aeronerd/KiCad/projects/DemoBoard1/pcb_resources/heart-shape.dxf

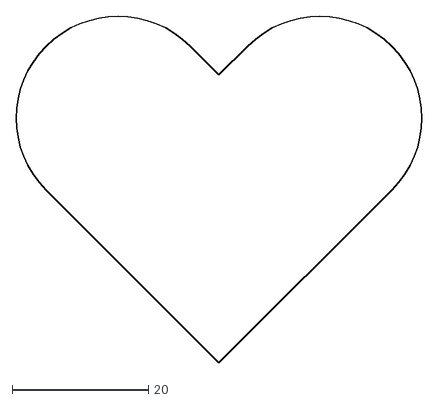
[picture p1: CAD file, 2018-10-02]
projects/DemoBoard1/pcb_resources/heart-shape.dxf
59.6 x 50.9
