aeronerd/KiCad/projects/BikeLightComputerRev2/BikeLightComputerRev2.kicad_pcb

## KiCad design projects/BikeLightComputerRev2/BikeLightComputerRev2.kicad_pcb (2020-08-28)

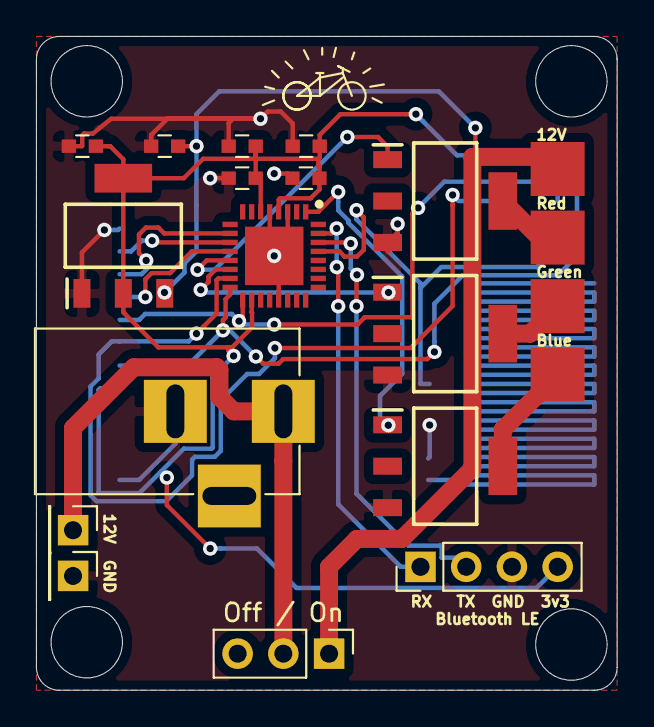
[picture p2: board BikeLightComputerRev2.kicad_pcb from above]

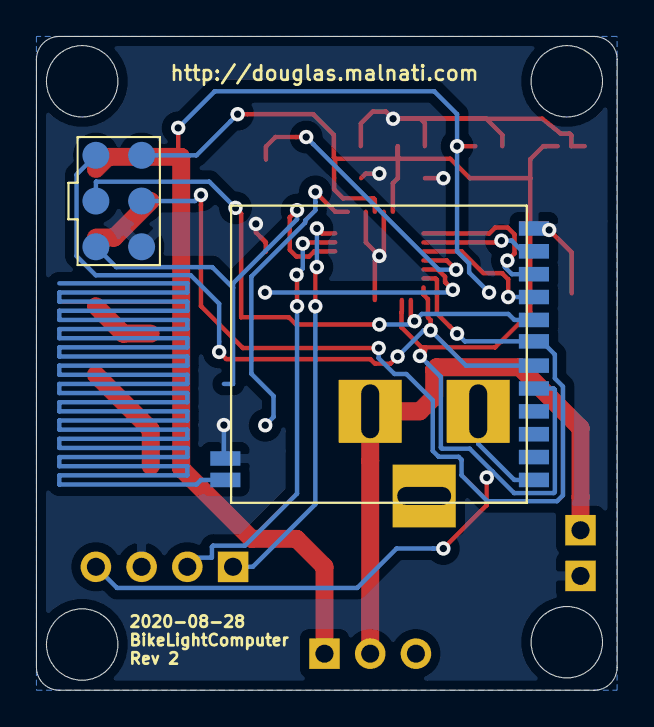
[picture p3: board BikeLightComputerRev2.kicad_pcb from below]

Board: 2 copper layers, 32.3 x 36.3 mm, 27 parts (7 on the bottom side), 19 nets.

Parts:
C1, C2, C3, C4, C5, C6: 1uF; C_0603
IC1, IC2, IC3: MOSFET_SOT223_FQT13N06TF; SOT-223-4
IC4: REG_3V3_NCP1117ST33T3G; SOT-223-4
J1: Barrel_Jack_MountingPin; BARREL_JACK
J3, J4: Conn_01x01_Male; Socket_Strip_Straight_1x01_Pitch2.54mm
J5: Conn_01x04_Female; Socket_Strip_Straight_1x04_Pitch2.54mm
J6, J7, J8, J9: Conn_01x01_Male; Measurement_Point_Square-SMD-Pad_Big
J10, J11, J12, J13, J14, J15: Conn_01x01_Male; Measurement_Point_Round-SMD-Pad_Small
J16: Conn_01x03_Male; Socket_Strip_Straight_1x03_Pitch2.54mm
U1: ATMEGA328P-MU
U2: RF4463PRO_LiteralLayout

Connections:
AVR_PWM_BLUE: IC3.1, U1.1
AVR_PWM_GREEN: IC2.1, U1.14
AVR_PWM_RED: IC1.1, U1.13
AVR_SER_RX: J5.2, U1.30
AVR_SER_TX: J5.1, U1.31
GND: C1.1, C2.1, C3.1, C4.1, C5.2, C6.1, IC1.3, IC2.3, IC3.3, IC4.1, J1.2, J4.1, J5.3, J15.1, U1.3, U1.5, U1.21, U1.33, U2.1, U2.12, U2.13
unnamed: IC1.4, J7.1
unnamed: IC2.4, J8.1
unnamed: IC3.4, J9.1
unnamed: J1.1, J3.1, J16.2
RADIO_NIRQ: U1.10, U2.10
RADIO_NSEL: U1.12, U2.9
RADIO_SDN: U1.11, U2.11
SPI_MISO: J10.1, U1.16, U2.6
SPI_MOSI: J14.1, U1.15, U2.7
SPI_RESET: J12.1, U1.29
SPI_SCK: J11.1, U1.17, U2.8
VCC: C1.2, C2.2, C3.2, C4.2, C6.2, IC4.2, IC4.4, J5.4, J13.1, U1.4, U1.6, U1.18, U2.5
VOLTAGE_INPUT: C5.1, IC4.3, J6.1, J16.1
