aeronerd/KiCad/projects/BreakoutSI4463PRORev3/BreakoutSI4463PRORev3.kicad_pcb

## KiCad design projects/BreakoutSI4463PRORev3/BreakoutSI4463PRORev3.kicad_pcb (2020-07-12)

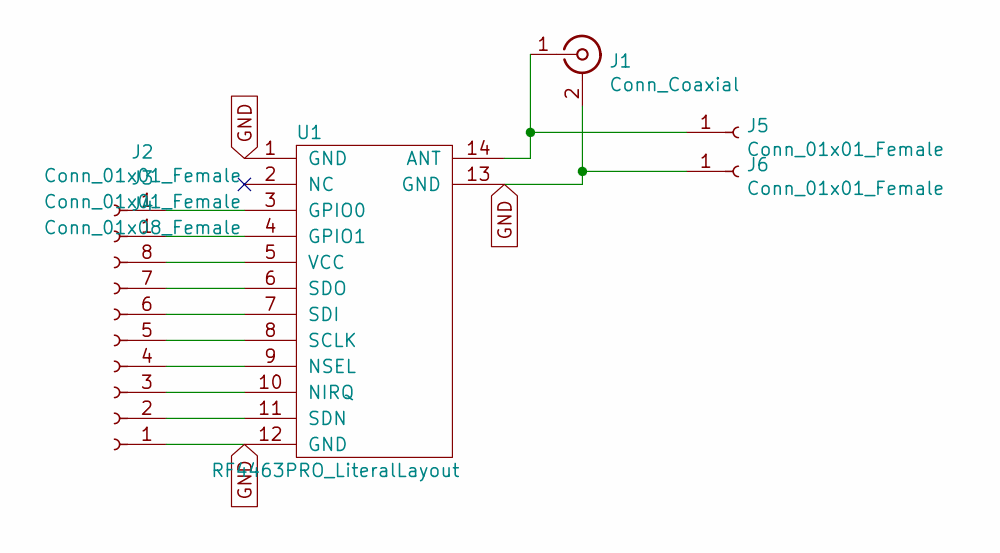
[picture p4: schematic BreakoutSI4463PRORev3.sch]

Parts:
J1: Conn_Coaxial; SMA_EdgeMount_BackOnly
J2, J3, J5, J6: Conn_01x01_Female; Pin_Header_Straight_1x01_Pitch2.54mm
J4: Conn_01x08_Female; Pin_Header_Straight_1x08_Pitch2.54mm
U1: RF4463PRO_LiteralLayout

Connections:
GND: J1.2 (Ext), J4.1, J6.1, U1.1 (GND), U1.12 (GND), U1.13 (GND)
unnamed: J1.1 (In), J5.1, U1.14 (ANT)
unnamed: J2.1, U1.3 (GPIO0)
unnamed: J3.1, U1.4 (GPIO1)
unnamed: J4.2, U1.11 (SDN)
unnamed: J4.3, U1.10 (NIRQ)
unnamed: J4.4, U1.9 (NSEL)
unnamed: J4.5, U1.8 (SCLK)
unnamed: J4.6, U1.7 (SDI)
unnamed: J4.7, U1.6 (SDO)
unnamed: J4.8, U1.5 (VCC)

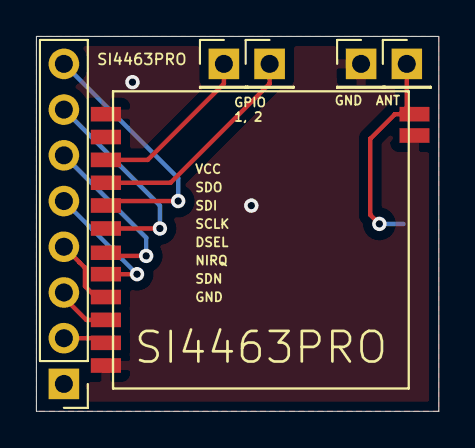
[picture p5: board BreakoutSI4463PRORev3.kicad_pcb from above]

Board: 2 copper layers, 22.4 x 20.8 mm, 7 parts (0 on the bottom side), 11 nets.
