aeronerd/KiCad/projects/BreakoutSI4463PRORev2/BreakoutSI4463PRORev2.kicad_pcb

## KiCad design projects/BreakoutSI4463PRORev2/BreakoutSI4463PRORev2.kicad_pcb (2020-06-27)

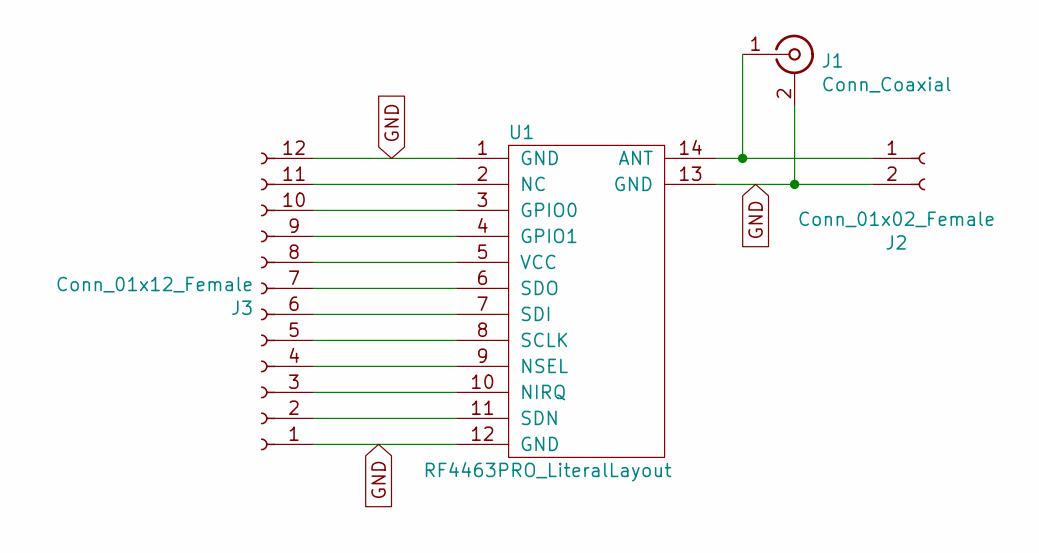
[picture p6: schematic BreakoutSI4463PRORev2.sch]

Parts:
J1: Conn_Coaxial; SMA_Samtec_SMA-J-P-X-ST-EM1_EdgeMount
J2: Conn_01x02_Female; Socket_Strip_Straight_1x02_Pitch2.54mm
J3: Conn_01x12_Female; Socket_Strip_Straight_1x12_Pitch2.54mm
U1: RF4463PRO_LiteralLayout

Connections:
GND: J1.2 (Ext), J2.2, J3.1, J3.12, U1.1 (GND), U1.12 (GND), U1.13 (GND)
unnamed: J1.1 (In), J2.1, U1.14 (ANT)
unnamed: J3.2, U1.11 (SDN)
unnamed: J3.3, U1.10 (NIRQ)
unnamed: J3.4, U1.9 (NSEL)
unnamed: J3.5, U1.8 (SCLK)
unnamed: J3.6, U1.7 (SDI)
unnamed: J3.7, U1.6 (SDO)
unnamed: J3.8, U1.5 (VCC)
unnamed: J3.9, U1.4 (GPIO1)
unnamed: J3.10, U1.3 (GPIO0)
unnamed: J3.11, U1.2 (NC)

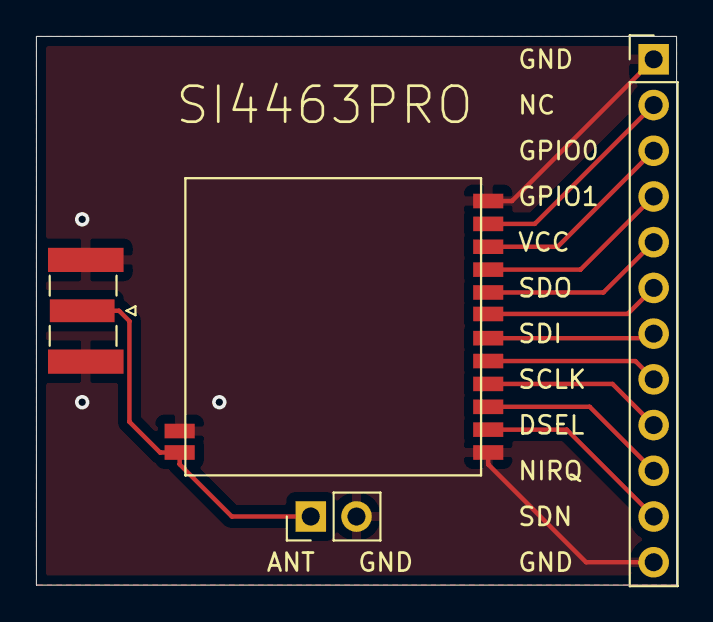
[picture p7: board BreakoutSI4463PRORev2.kicad_pcb from above]

Board: 2 copper layers, 35.6 x 30.5 mm, 4 parts (0 on the bottom side), 12 nets.
