aeronerd/KiCad/projects/PicoTrackerWSPR2Rev2/PicoTrackerWSPR2Rev2.kicad_pcb

## KiCad design projects/PicoTrackerWSPR2Rev2/PicoTrackerWSPR2Rev2.kicad_pcb (2020-04-08)

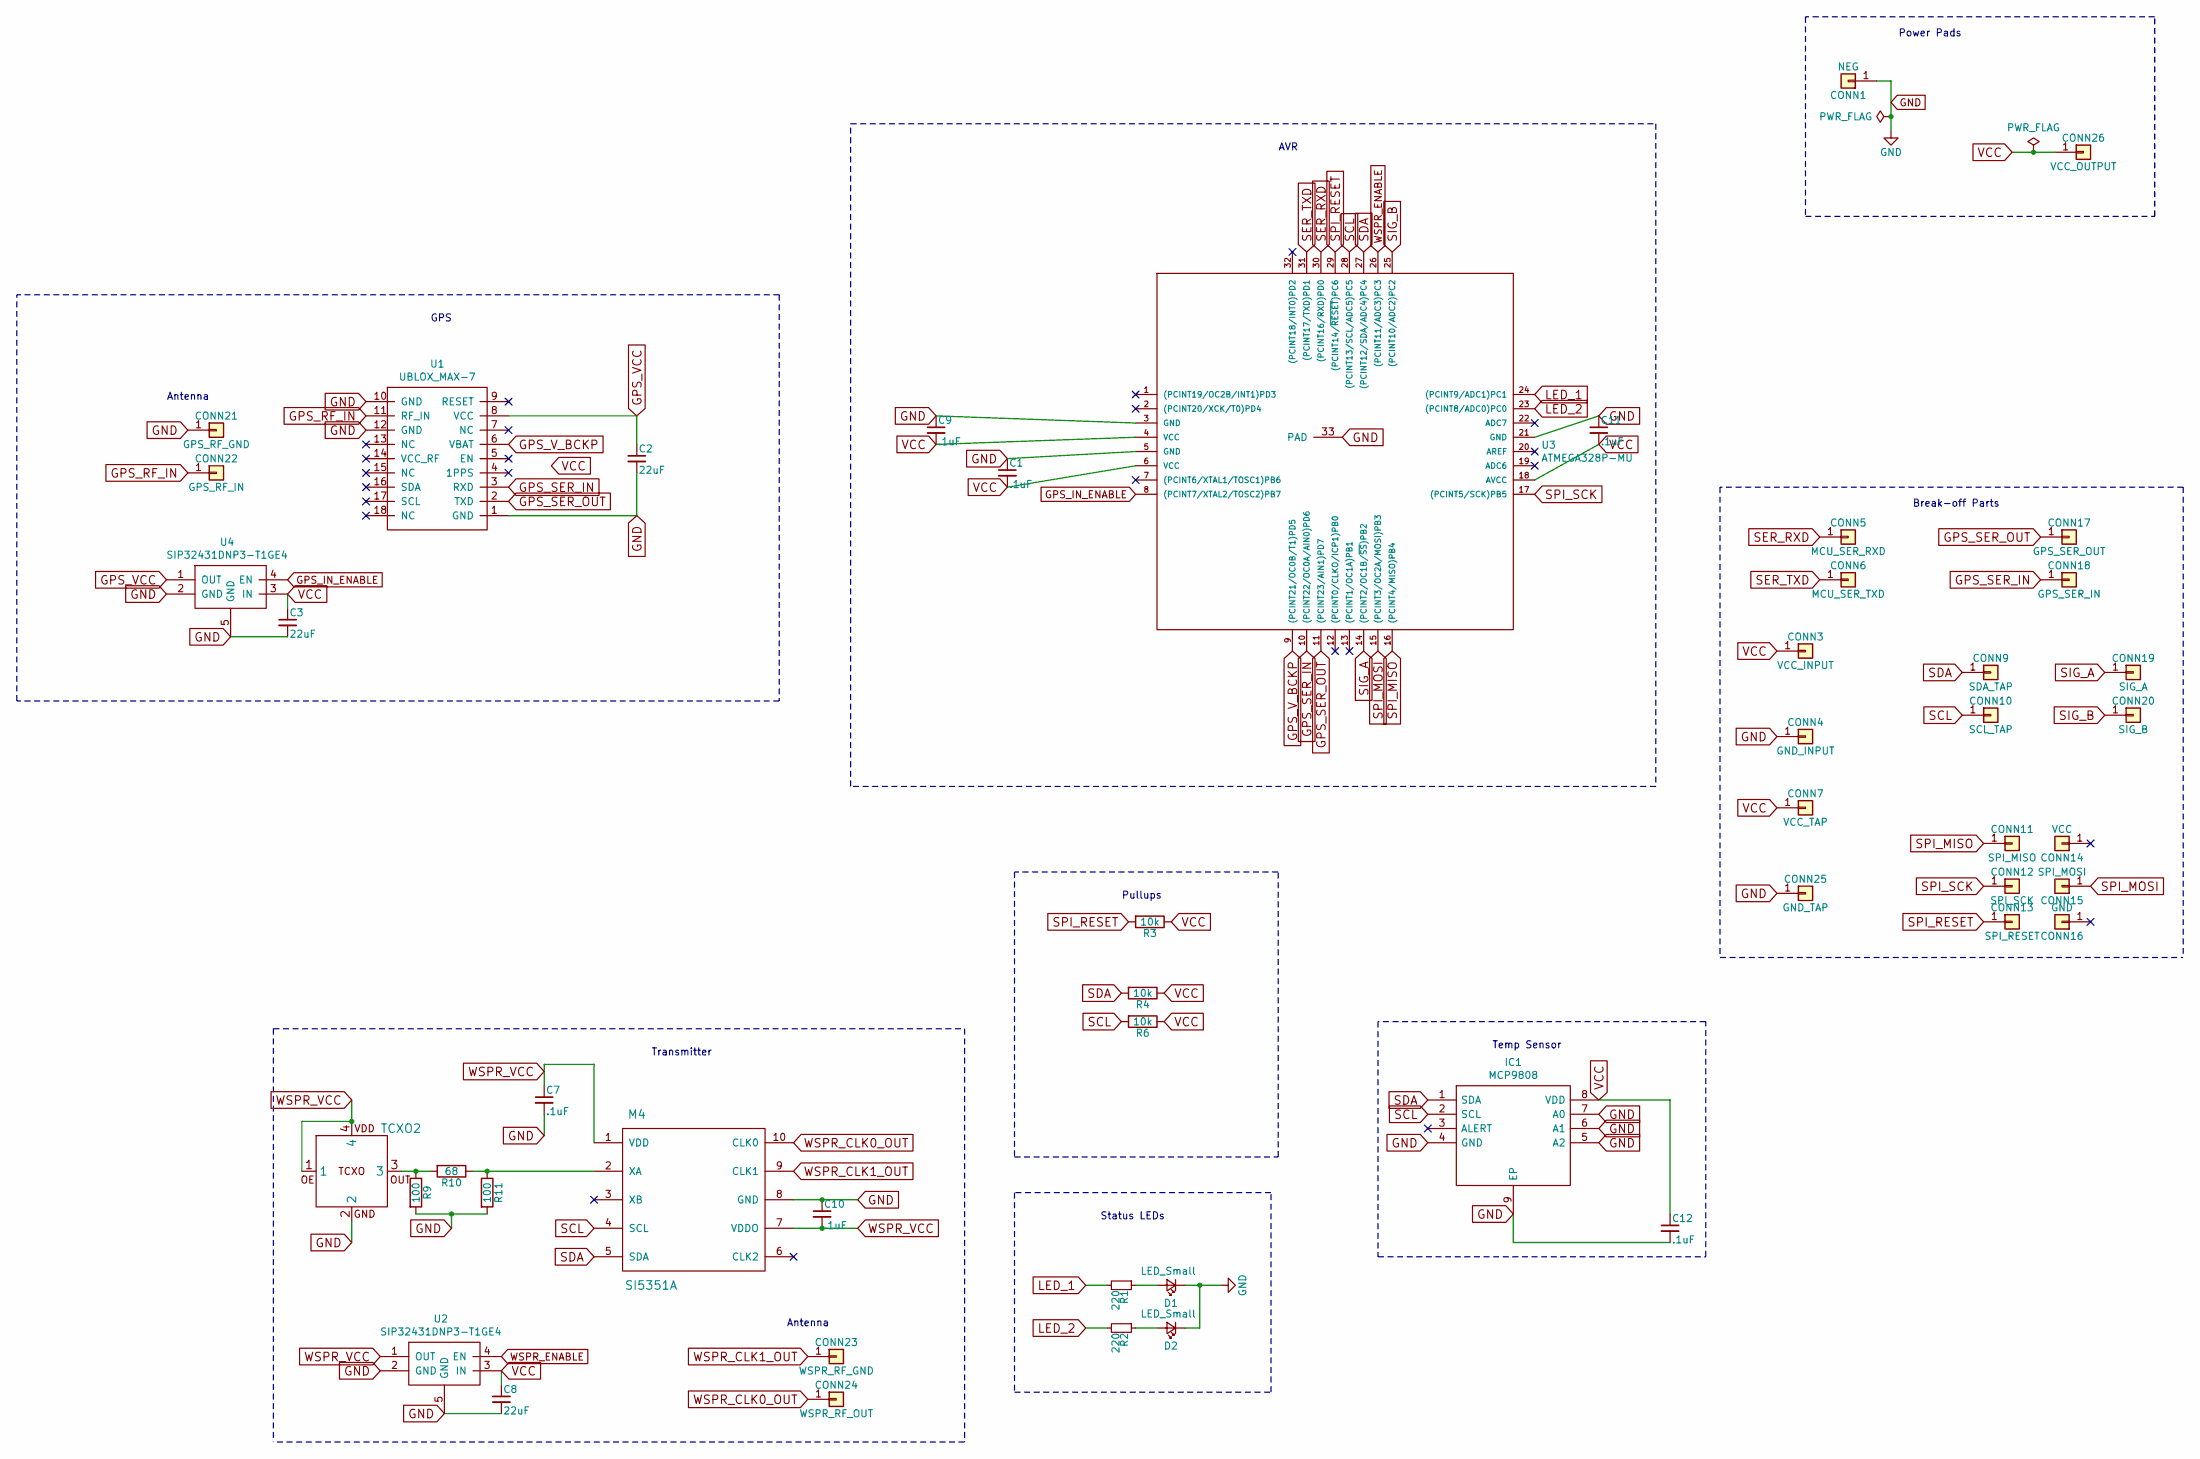
[picture p8: schematic PicoTrackerWSPR2Rev2.sch]

Parts:
C1, C7, C9, C10, C11, C12: .1uF; C_0603_HandSoldering
C2, C3, C8: 22uF; C_0603_HandSoldering
CONN1: NEG; Measurement_Point_Square-SMD-Pad_Big
CONN3: VCC_INPUT; Socket_Strip_Straight_1x01_Pitch2.54mm
CONN4: GND_INPUT; Socket_Strip_Straight_1x01_Pitch2.54mm
CONN5: MCU_SER_RXD; Socket_Strip_Straight_1x01_Pitch2.54mm
CONN6: MCU_SER_TXD; Socket_Strip_Straight_1x01_Pitch2.54mm
CONN7: VCC_TAP; Socket_Strip_Straight_1x01_Pitch2.54mm
CONN9: SDA_TAP; Socket_Strip_Straight_1x01_Pitch2.54mm
CONN10: SCL_TAP; Socket_Strip_Straight_1x01_Pitch2.54mm
CONN11: SPI_MISO; Pin_Header_Straight_1x01_Pitch2.54mm
CONN12: SPI_SCK; Pin_Header_Straight_1x01_Pitch2.54mm
CONN13: SPI_RESET; Pin_Header_Straight_1x01_Pitch2.54mm
CONN14: VCC; Pin_Header_Straight_1x01_Pitch2.54mm
CONN15: SPI_MOSI; Pin_Header_Straight_1x01_Pitch2.54mm
CONN16: GND; Pin_Header_Straight_1x01_Pitch2.54mm
CONN17: GPS_SER_OUT; Socket_Strip_Straight_1x01_Pitch2.54mm
CONN18: GPS_SER_IN; Socket_Strip_Straight_1x01_Pitch2.54mm
CONN19: SIG_A; Socket_Strip_Straight_1x01_Pitch2.54mm
CONN20: SIG_B; Socket_Strip_Straight_1x01_Pitch2.54mm
CONN21: GPS_RF_GND; Measurement_Point_Square-SMD-Pad_Big
CONN22: GPS_RF_IN; Measurement_Point_Square-SMD-Pad_Big
CONN23: WSPR_RF_GND; Measurement_Point_Square-SMD-Pad_Small
CONN24: WSPR_RF_OUT; Measurement_Point_Square-SMD-Pad_Small
CONN25: GND_TAP; Socket_Strip_Straight_1x01_Pitch2.54mm
CONN26: VCC_OUTPUT; Measurement_Point_Square-SMD-Pad_Big
D1, D2: LED_Small; LED_0603_HandSoldering
IC1: MCP9808
M4: SI5351A
R1, R2: 220; R_0603_HandSoldering
R3, R4, R6: 10k; R_0603_HandSoldering
R9, R11: 100; R_0603_HandSoldering
R10: 68; R_0603_HandSoldering
TCXO2: CRYSTAL_TCXO_3.2mmWidth_2.5mmHeight; CRYSTAL_3.2mmWidth_2.5mmHeight
U1: UBLOX_MAX-7
U2, U4: SIP32431DNP3-T1GE4
U3: ATMEGA328P-MU

Connections:
GND: C1.1, C2.2, C3.2, C7.2, C8.2, C9.1, C10.1, C11.1, C12.2, CONN1.1, CONN4.1, CONN21.1, CONN25.1, D1.1 (K), D2.1 (K), IC1.4 (GND), IC1.5 (A2), IC1.6 (A1), IC1.7 (A0), IC1.9 (EP), M4.8 (GND), R9.2, R11.2, TCXO2.2, U1.1 (GND), U1.10 (GND), U1.12 (GND), U2.2 (GND), U2.5 (GND), U3.3 (GND), U3.5 (GND), U3.21 (GND), U3.33 (PAD), U4.2 (GND), U4.5 (GND)
GPS_IN_ENABLE: U3.8 ((PCINT7/XTAL2/TOSC2)PB7), U4.4 (EN)
GPS_RF_IN: CONN22.1, U1.11 (RF_IN)
GPS_SER_IN: CONN18.1, U1.3 (RXD), U3.10 ((PCINT22/OC0A/AIN0)PD6)
GPS_SER_OUT: CONN17.1, U1.2 (TXD), U3.11 ((PCINT23/AIN1)PD7)
GPS_VCC: C2.1, U1.8 (VCC), U4.1 (OUT)
GPS_V_BCKP: U1.6 (VBAT), U3.9 ((PCINT21/OC0B/T1)PD5)
LED_1: R1.2, U3.24 ((PCINT9/ADC1)PC1)
LED_2: R2.2, U3.23 ((PCINT8/ADC0)PC0)
unnamed: D1.2 (A), R1.1
unnamed: D2.2 (A), R2.1
unnamed: M4.2 (XA), R10.1, R11.1
unnamed: R9.1, R10.2, TCXO2.3
SCL: CONN10.1, IC1.2 (SCL), M4.4 (SCL), R6.2, U3.28 ((PCINT13/SCL/ADC5)PC5)
SDA: CONN9.1, IC1.1 (SDA), M4.5 (SDA), R4.2, U3.27 ((PCINT12/SDA/ADC4)PC4)
SER_RXD: CONN5.1, U3.30 ((PCINT16/RXD)PD0)
SER_TXD: CONN6.1, U3.31 ((PCINT17/TXD)PD1)
SIG_A: CONN19.1, U3.14 ((PCINT2/OC1B/~SS~)PB2)
SIG_B: CONN20.1, U3.25 ((PCINT10/ADC2)PC2)
SPI_MISO: CONN11.1, U3.16 ((PCINT4/MISO)PB4)
SPI_MOSI: CONN15.1, U3.15 ((PCINT3/OC2A/MOSI)PB3)
SPI_RESET: CONN13.1, R3.2, U3.29 ((PCINT14/~RESET~)PC6)
SPI_SCK: CONN12.1, U3.17 ((PCINT5/SCK)PB5)
VCC: C1.2, C3.1, C8.1, C9.2, C11.2, C12.1, CONN3.1, CONN7.1, CONN26.1, IC1.8 (VDD), R3.1, R4.1, R6.1, U2.3 (IN), U3.4 (VCC), U3.6 (VCC), U3.18 (AVCC), U4.3 (IN)
WSPR_CLK0_OUT: CONN24.1, M4.10 (CLK0)
WSPR_CLK1_OUT: CONN23.1, M4.9 (CLK1)
WSPR_ENABLE: U2.4 (EN), U3.26 ((PCINT11/ADC3)PC3)
WSPR_VCC: C7.1, C10.2, M4.1 (VDD), M4.7 (VDDO), TCXO2.1, TCXO2.4, U2.1 (OUT)

Notes on the sheet:
Break-off Parts
Pullups
Status LEDs
Antenna
Transmitter
GPS
Power Pads
AVR
Temp Sensor

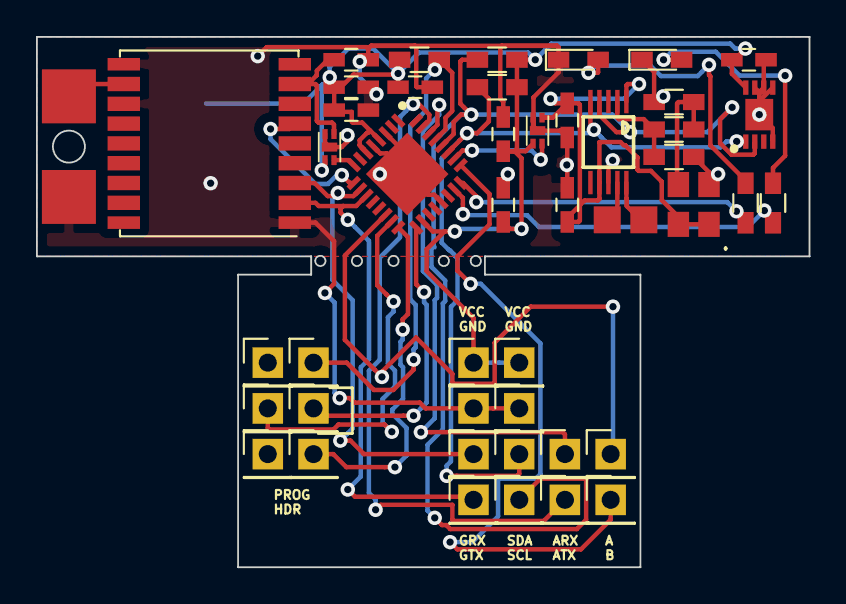
[picture p9: board PicoTrackerWSPR2Rev2.kicad_pcb from above]

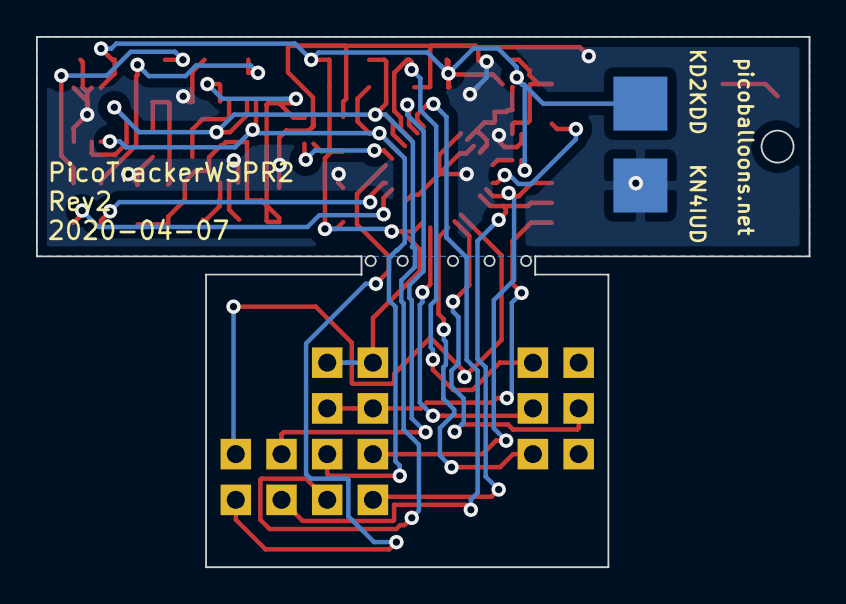
[picture p10: board PicoTrackerWSPR2Rev2.kicad_pcb from below]

Board: 2 copper layers, 42.9 x 29.5 mm, 50 parts (2 on the bottom side), 28 nets.
