aeronerd/KiCad/projects/BreakoutGPSATGM336H/BreakoutGPSATGM336H.kicad_pcb

## KiCad design projects/BreakoutGPSATGM336H/BreakoutGPSATGM336H.kicad_pcb (2020-03-16)

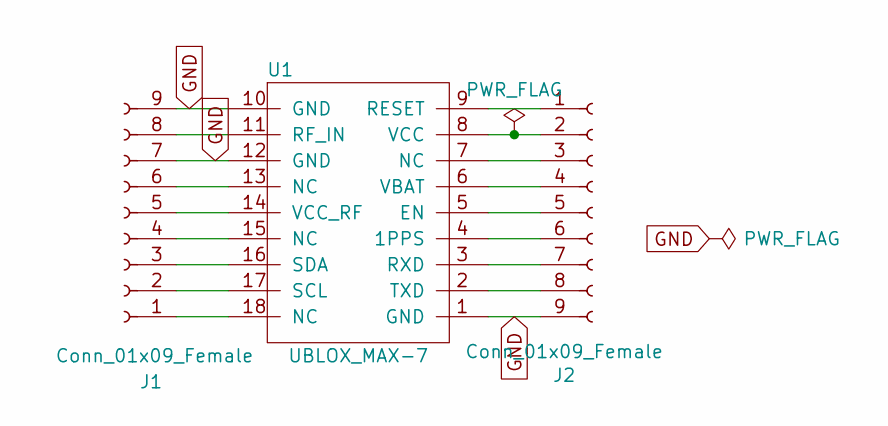
[picture p11: schematic BreakoutGPSATGM336H.sch]

Parts:
J1, J2: Conn_01x09_Female; Socket_Strip_Straight_1x09_Pitch2.54mm
U1: UBLOX_MAX-7

Connections:
GND: J1.7, J1.9, J2.9, U1.1 (GND), U1.10 (GND), U1.12 (GND)
unnamed: J1.1, U1.18 (NC)
unnamed: J1.2, U1.17 (SCL)
unnamed: J1.3, U1.16 (SDA)
unnamed: J1.4, U1.15 (NC)
unnamed: J1.5, U1.14 (VCC_RF)
unnamed: J1.6, U1.13 (NC)
unnamed: J1.8, U1.11 (RF_IN)
unnamed: J2.1, U1.9 (RESET)
unnamed: J2.2, U1.8 (VCC)
unnamed: J2.3, U1.7 (NC)
unnamed: J2.4, U1.6 (VBAT)
unnamed: J2.5, U1.5 (EN)
unnamed: J2.6, U1.4 (1PPS)
unnamed: J2.7, U1.3 (RXD)
unnamed: J2.8, U1.2 (TXD)

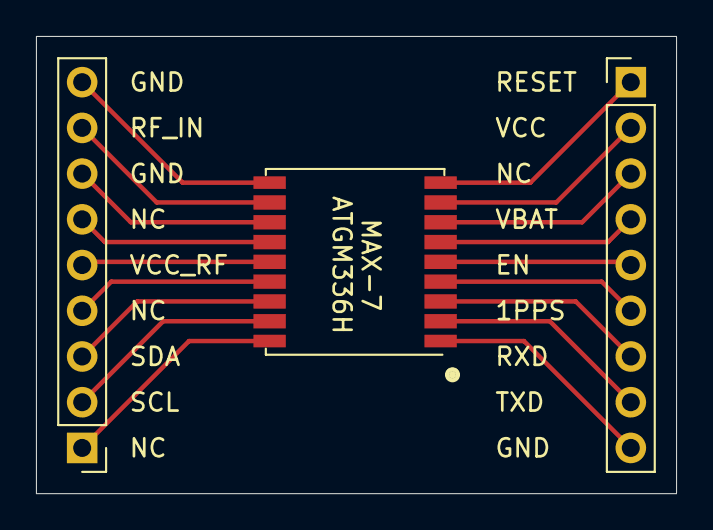
[picture p12: board BreakoutGPSATGM336H.kicad_pcb from above]

Board: 2 copper layers, 35.6 x 25.4 mm, 3 parts (0 on the bottom side), 16 nets.
