aeronerd/KiCad/projects/PicoTrackerWSPR1Rev5/PicoTrackerWSPR1Rev5.kicad_pcb

## KiCad design projects/PicoTrackerWSPR1Rev5/PicoTrackerWSPR1Rev5.kicad_pcb (2019-05-22)

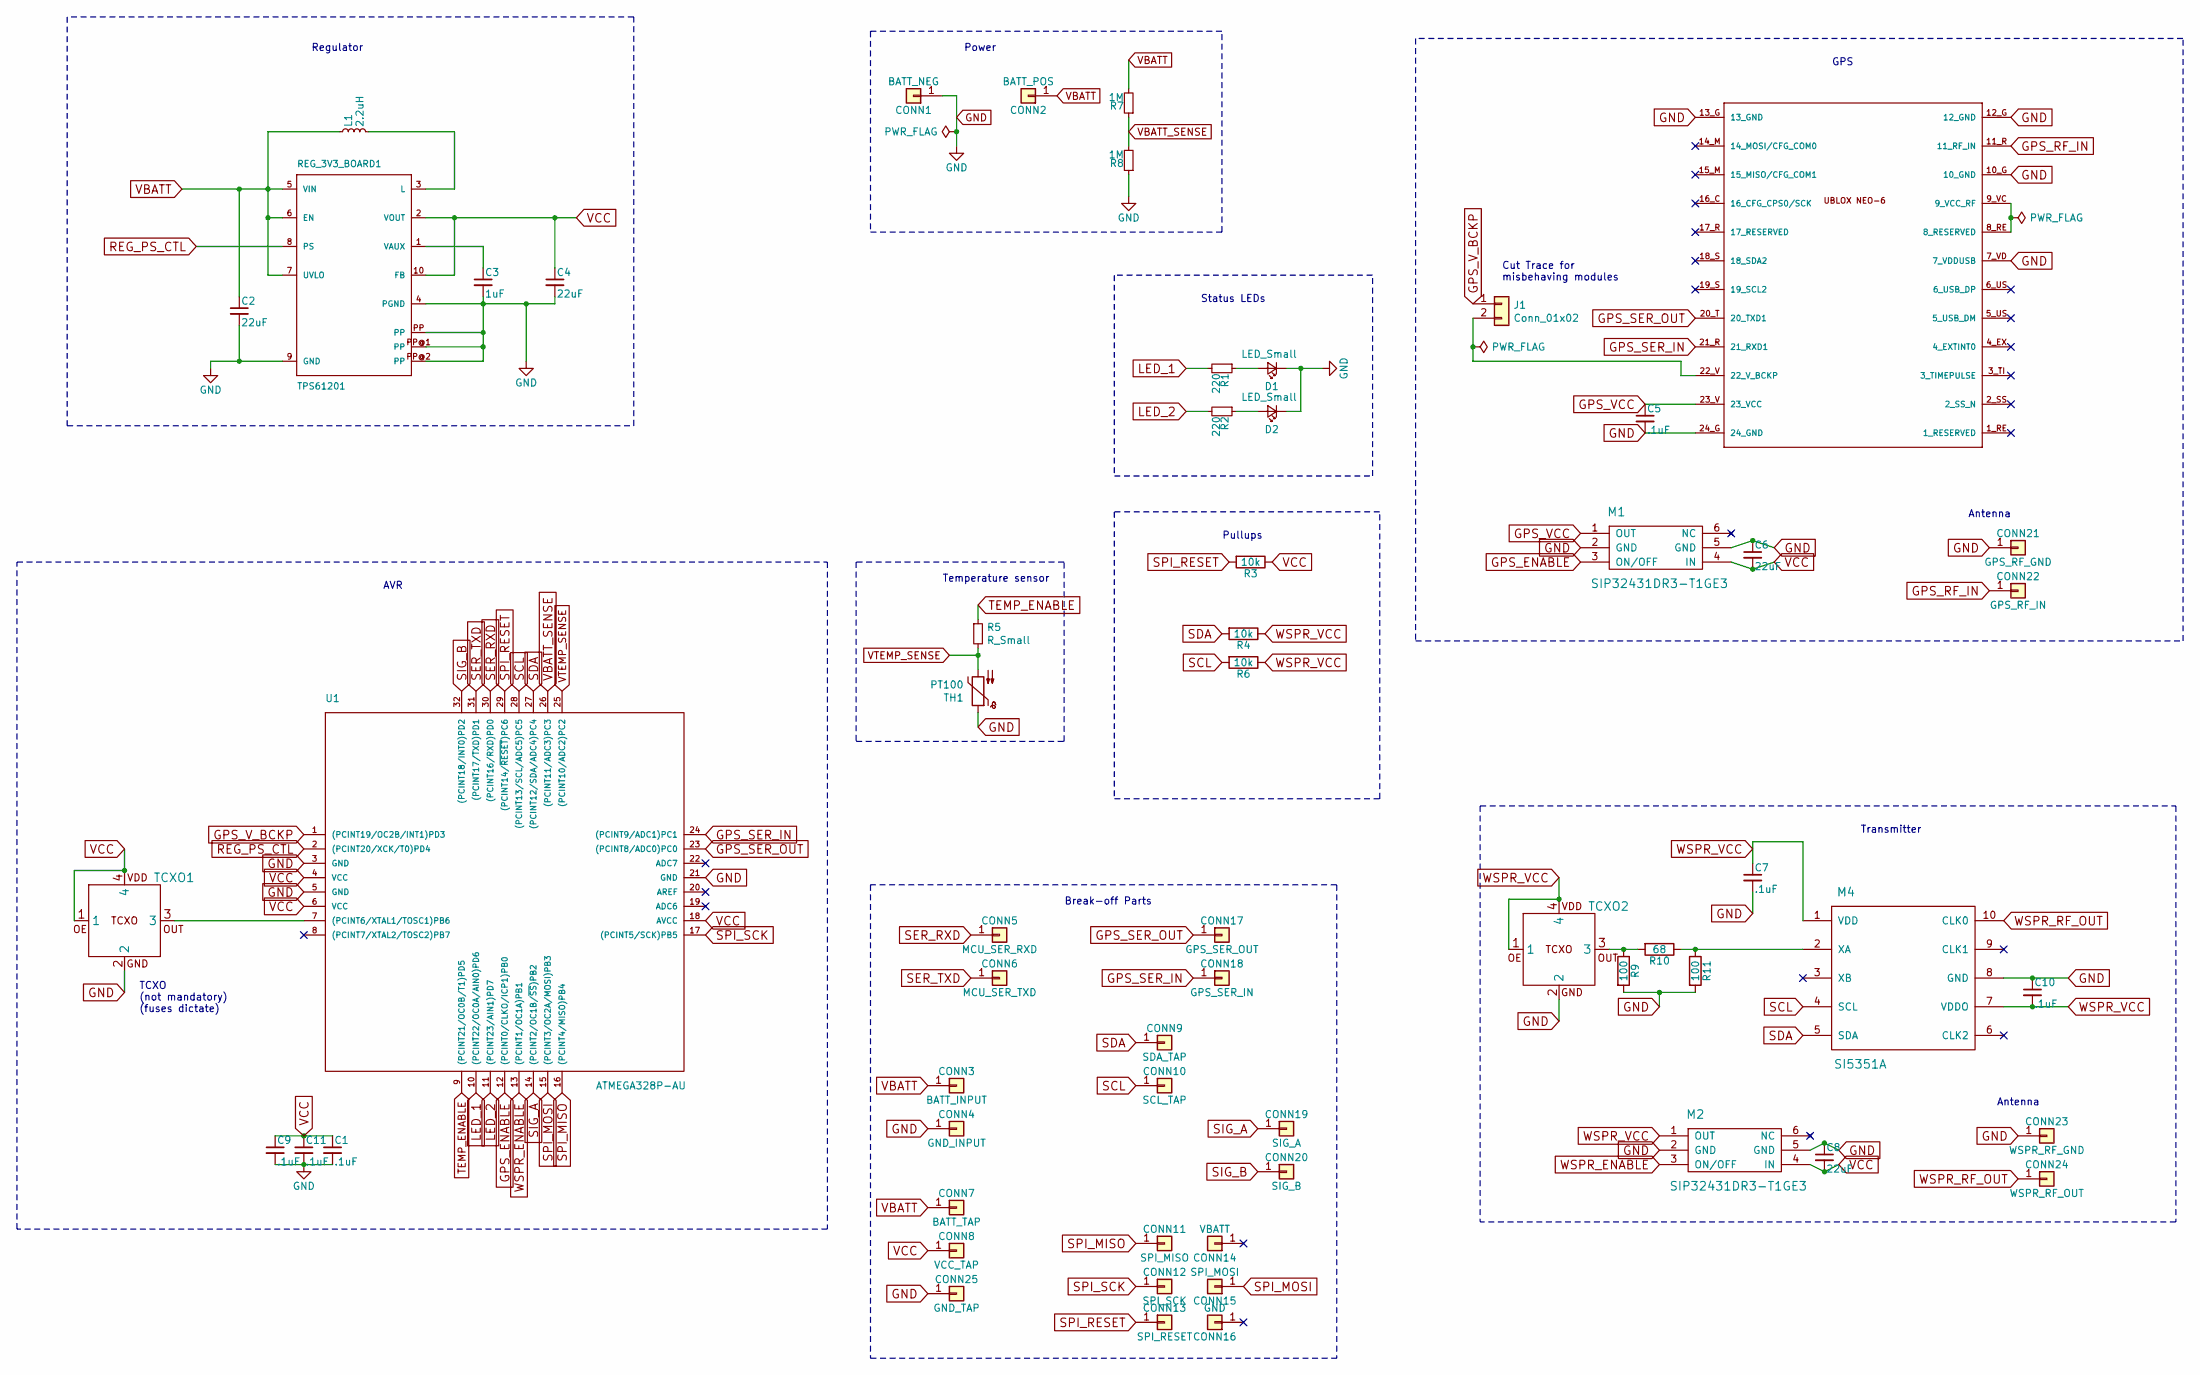
[picture p13: schematic PicoTrackerWSPR1Rev5.sch]

Parts:
C1, C5, C7, C9, C10, C11: .1uF; C_0603_HandSoldering
C2, C4, C6, C8: 22uF; C_0603_HandSoldering
C3: 1uF; C_0603_HandSoldering
CONN1: BATT_NEG; Measurement_Point_Square-SMD-Pad_Big
CONN2: BATT_POS; Measurement_Point_Square-SMD-Pad_Big
CONN3: BATT_INPUT; Socket_Strip_Straight_1x01_Pitch2.54mm
CONN4: GND_INPUT; Socket_Strip_Straight_1x01_Pitch2.54mm
CONN5: MCU_SER_RXD; Socket_Strip_Straight_1x01_Pitch2.54mm
CONN6: MCU_SER_TXD; Socket_Strip_Straight_1x01_Pitch2.54mm
CONN7: BATT_TAP; Socket_Strip_Straight_1x01_Pitch2.54mm
CONN8: VCC_TAP; Socket_Strip_Straight_1x01_Pitch2.54mm
CONN9: SDA_TAP; Socket_Strip_Straight_1x01_Pitch2.54mm
CONN10: SCL_TAP; Socket_Strip_Straight_1x01_Pitch2.54mm
CONN11: SPI_MISO; Pin_Header_Straight_1x01_Pitch2.54mm
CONN12: SPI_SCK; Pin_Header_Straight_1x01_Pitch2.54mm
CONN13: SPI_RESET; Pin_Header_Straight_1x01_Pitch2.54mm
CONN14: VBATT; Pin_Header_Straight_1x01_Pitch2.54mm
CONN15: SPI_MOSI; Pin_Header_Straight_1x01_Pitch2.54mm
CONN16: GND; Pin_Header_Straight_1x01_Pitch2.54mm
CONN17: GPS_SER_OUT; Socket_Strip_Straight_1x01_Pitch2.54mm
CONN18: GPS_SER_IN; Socket_Strip_Straight_1x01_Pitch2.54mm
CONN19: SIG_A; Socket_Strip_Straight_1x01_Pitch2.54mm
CONN20: SIG_B; Socket_Strip_Straight_1x01_Pitch2.54mm
CONN21: GPS_RF_GND; Measurement_Point_Square-SMD-Pad_Big
CONN22: GPS_RF_IN; Measurement_Point_Square-SMD-Pad_Big
CONN23: WSPR_RF_GND; Measurement_Point_Square-SMD-Pad_Small
CONN24: WSPR_RF_OUT; Measurement_Point_Square-SMD-Pad_Small
CONN25: GND_TAP; Socket_Strip_Straight_1x01_Pitch2.54mm
D1, D2: LED_Small; LED_0603_HandSoldering
J1: Conn_01x02; CUT_TRACE
L1: 2.2uH; coilcraft-LPS3015-222
M1, M2: SIP32431DR3-T1GE3; SOT-363_SC-70-6_Handsoldering
M3: UBLOX_NEO-6
M4: SI5351A
R1, R2: 220; R_0603_HandSoldering
R3, R4, R6: 10k; R_0603_HandSoldering
R5: R_Small; R_0603_HandSoldering
R7, R8: 1M; R_0603_HandSoldering
R9, R11: 100; R_0603_HandSoldering
R10: 68; R_0603_HandSoldering
REG_3V3_BOARD1: TPS61201; texas-S-PDSO-N10
TCXO1, TCXO2: CRYSTAL_TCXO_3.2mmWidth_2.5mmHeight; CRYSTAL_3.2mmWidth_2.5mmHeight
TH1: PT100; PTS060301B100RP100
U1: ATMEGA328P-AU; TQFP-32_7x7mm_Pitch0.8mm

Connections:
GND: C1.2, C2.2, C3.2, C4.2, C5.2, C6.1, C7.2, C8.1, C9.2, C10.1, C11.2, CONN1.1, CONN4.1, CONN21.1, CONN23.1, CONN25.1, D1.1 (K), D2.1 (K), M1.2 (GND), M1.5 (GND), M2.2 (GND), M2.5 (GND), M3.7_VD (7_VDDUSB), M3.10_G (10_GND), M3.12_G (12_GND), M3.13_G (13_GND), M3.24_G (24_GND), M4.8 (GND), R8.1, R9.2, R11.2, REG_3V3_BOARD1.4 (PGND), REG_3V3_BOARD1.9 (GND), REG_3V3_BOARD1.PP, REG_3V3_BOARD1.PP@1 (PP), REG_3V3_BOARD1.PP@2 (PP), TCXO1.2, TCXO2.2, TH1.1, U1.3 (GND), U1.5 (GND), U1.21 (GND)
GPS_ENABLE: M1.3 (ON/OFF), U1.12 ((PCINT0/CLKO/ICP1)PB0)
GPS_RF_IN: CONN22.1, M3.11_R (11_RF_IN)
GPS_SER_IN: CONN18.1, M3.21_R (21_RXD1), U1.24 ((PCINT9/ADC1)PC1)
GPS_SER_OUT: CONN17.1, M3.20_T (20_TXD1), U1.23 ((PCINT8/ADC0)PC0)
GPS_VCC: C5.1, M1.1 (OUT), M3.23_V (23_VCC)
GPS_V_BCKP: J1.1, U1.1 ((PCINT19/OC2B/INT1)PD3)
LED_1: R1.2, U1.10 ((PCINT22/OC0A/AIN0)PD6)
LED_2: R2.2, U1.11 ((PCINT23/AIN1)PD7)
unnamed: C3.1, REG_3V3_BOARD1.1 (VAUX)
unnamed: D1.2 (A), R1.1
unnamed: D2.2 (A), R2.1
unnamed: J1.2, M3.22_V (22_V_BCKP)
unnamed: L1.2, REG_3V3_BOARD1.3 (L)
unnamed: M3.8_RE (8_RESERVED), M3.9_VC (9_VCC_RF)
unnamed: M4.2 (XA), R10.1, R11.1
unnamed: R9.1, R10.2, TCXO2.3
unnamed: TCXO1.3, U1.7 ((PCINT6/XTAL1/TOSC1)PB6)
REG_PS_CTL: REG_3V3_BOARD1.8 (PS), U1.2 ((PCINT20/XCK/T0)PD4)
SCL: CONN10.1, M4.4 (SCL), R6.2, U1.28 ((PCINT13/SCL/ADC5)PC5)
SDA: CONN9.1, M4.5 (SDA), R4.2, U1.27 ((PCINT12/SDA/ADC4)PC4)
SER_RXD: CONN5.1, U1.30 ((PCINT16/RXD)PD0)
SER_TXD: CONN6.1, U1.31 ((PCINT17/TXD)PD1)
SIG_A: CONN19.1, U1.14 ((PCINT2/OC1B/~SS~)PB2)
SIG_B: CONN20.1, U1.32 ((PCINT18/INT0)PD2)
SPI_MISO: CONN11.1, U1.16 ((PCINT4/MISO)PB4)
SPI_MOSI: CONN15.1, U1.15 ((PCINT3/OC2A/MOSI)PB3)
SPI_RESET: CONN13.1, R3.2, U1.29 ((PCINT14/~RESET~)PC6)
SPI_SCK: CONN12.1, U1.17 ((PCINT5/SCK)PB5)
TEMP_ENABLE: R5.1, U1.9 ((PCINT21/OC0B/T1)PD5)
VBATT: C2.1, CONN2.1, CONN3.1, CONN7.1, L1.1, R7.2, REG_3V3_BOARD1.5 (VIN), REG_3V3_BOARD1.6 (EN), REG_3V3_BOARD1.7 (UVLO)
VBATT_SENSE: R7.1, R8.2, U1.26 ((PCINT11/ADC3)PC3)
VCC: C1.1, C4.1, C6.2, C8.2, C9.1, C11.1, CONN8.1, M1.4 (IN), M2.4 (IN), R3.1, REG_3V3_BOARD1.2 (VOUT), REG_3V3_BOARD1.10 (FB), TCXO1.1, TCXO1.4, U1.4 (VCC), U1.6 (VCC), U1.18 (AVCC)
VTEMP_SENSE: R5.2, TH1.2, U1.25 ((PCINT10/ADC2)PC2)
WSPR_ENABLE: M2.3 (ON/OFF), U1.13 ((PCINT1/OC1A)PB1)
WSPR_RF_OUT: CONN24.1, M4.10 (CLK0)
WSPR_VCC: C7.1, C10.2, M2.1 (OUT), M4.1 (VDD), M4.7 (VDDO), R4.1, R6.1, TCXO2.1, TCXO2.4

Notes on the sheet:
Break-off Parts
Pullups
Status LEDs
Antenna
Transmitter
GPS
Regulator
Power
Cut Trace for misbehaving modules
AVR
Temperature sensor
TCXO (not mandatory) (fuses dictate)

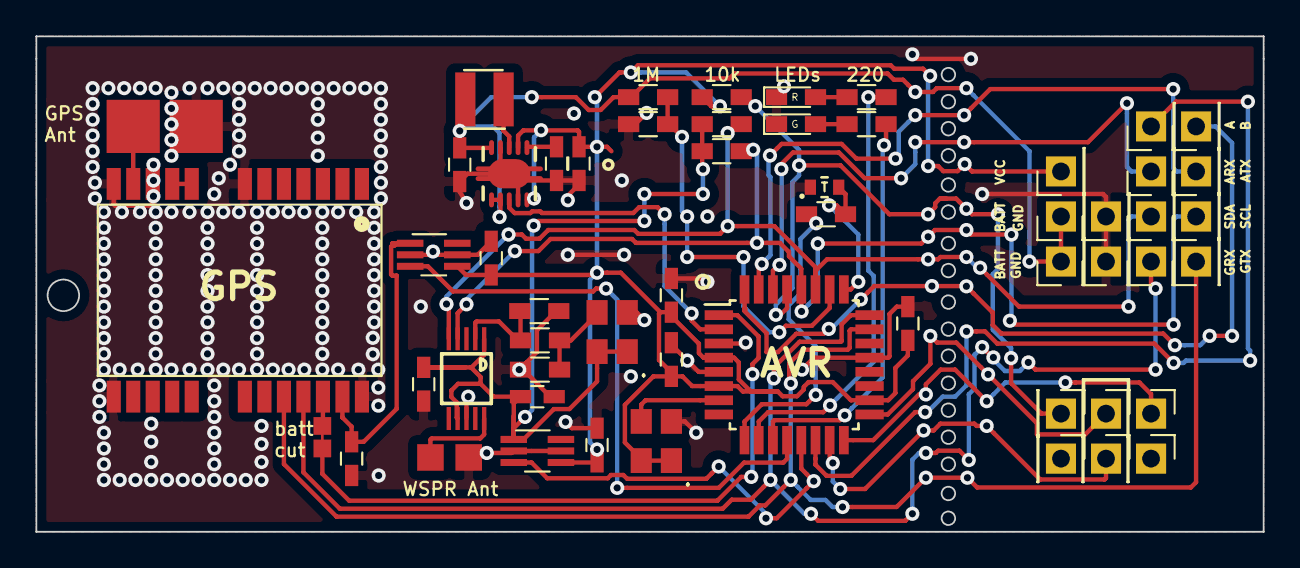
[picture p14: board PicoTrackerWSPR1Rev5.kicad_pcb from above]

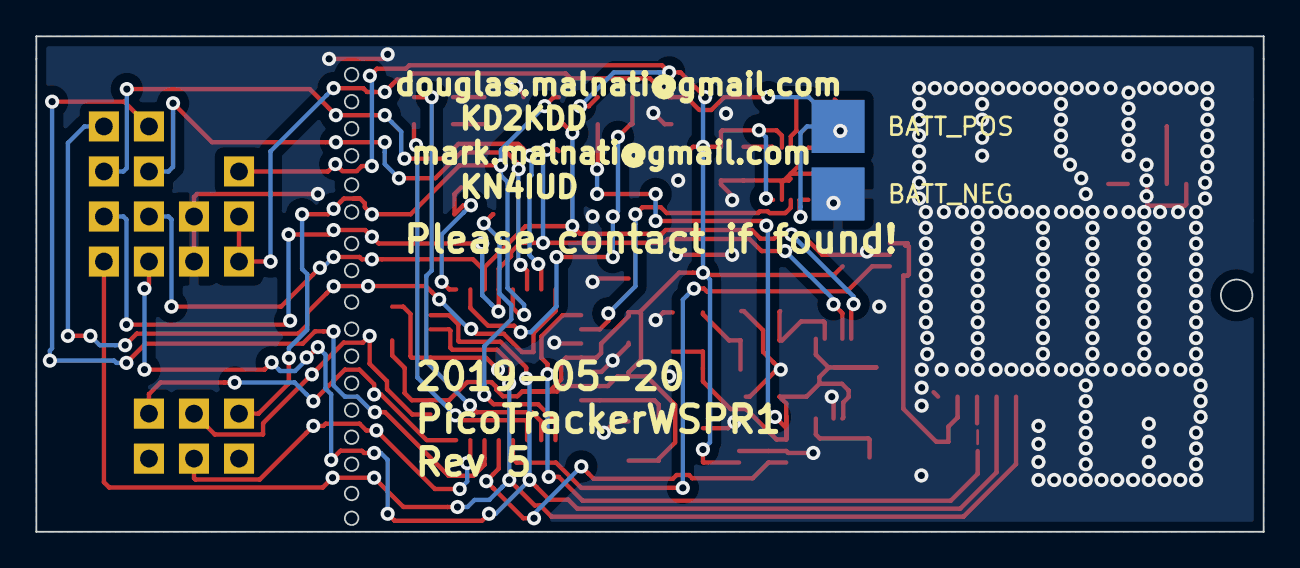
[picture p15: board PicoTrackerWSPR1Rev5.kicad_pcb from below]

Board: 2 copper layers, 69.2 x 27.9 mm, 60 parts (2 on the bottom side), 37 nets.
