aeronerd/KiCad/projects/ModuleSolarToStorageTunableLTC3105/ModuleSolarToStorageTunableLTC3105.kicad_pcb

## KiCad design projects/ModuleSolarToStorageTunableLTC3105/ModuleSolarToStorageTunableLTC3105.kicad_pcb (2019-03-30)

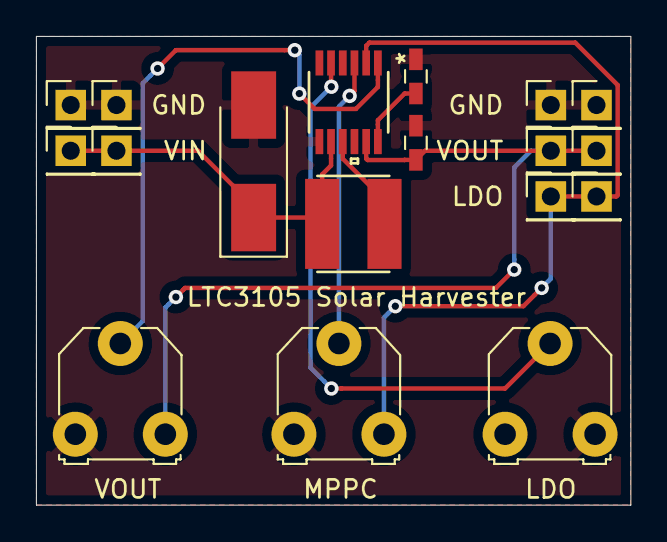
[picture p16: board ModuleSolarToStorageTunableLTC3105.kicad_pcb from above]

Board: 2 copper layers, 33.0 x 26.0 mm, 18 parts (0 on the bottom side), 9 nets.

Parts:
C1: ??uF; C_0603_HandSoldering
C2: 1uF; C_0603_HandSoldering
C3: ??uF; CP_Tantalum_Case-U_EIA-6032-15_Hand
J1, J1#2: VIN; Socket_Strip_Straight_1x01_Pitch2.54mm
J2, J2#2, J5, J5#2: GND; Socket_Strip_Straight_1x01_Pitch2.54mm
J3, J3#2: VOUT; Socket_Strip_Straight_1x01_Pitch2.54mm
J4, J4#2: LDO; Socket_Strip_Straight_1x01_Pitch2.54mm
L1: 10uH; coilcraft-MSS5131-103
RV1, RV2, RV3: 500k; Potentiometer_Triwood_RM-065
U1: LTC3105EMS-PBF

Connections:
GND: C1.2, C2.2, C3.2, J2.1, J2#2.1, J5.1, J5#2.1, RV1.1, RV2.1, RV3.3, U1.6, U1.7
LDO: J4.1, J4#2.1, RV1.3, U1.2
unnamed: C2.1, U1.12
unnamed: L1.1, U1.9
unnamed: RV1.2, U1.3
unnamed: RV2.2, U1.1
unnamed: RV3.2, U1.5
VIN: C3.1, J1.1, J1#2.1, L1.2, U1.8
VOUT: C1.1, J3.1, J3#2.1, RV2.3, U1.11
