aeronerd/KiCad/projects/ModuleSolarToStorageLTC3105/ModuleSolarToStorageLTC3105.kicad_pcb

## KiCad design projects/ModuleSolarToStorageLTC3105/ModuleSolarToStorageLTC3105.kicad_pcb (2019-03-30)

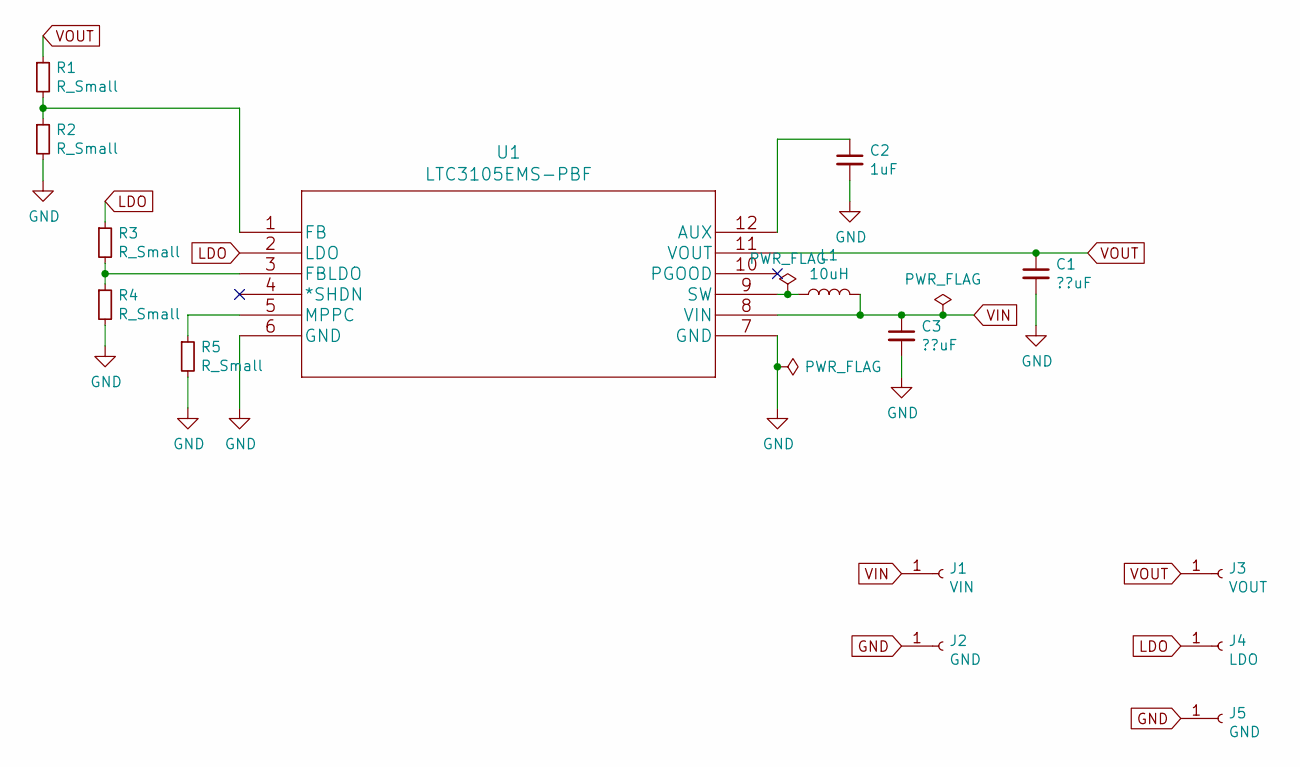
[picture p17: schematic ModuleSolarToStorageLTC3105.sch]

Parts:
C1: ??uF; C_0603_HandSoldering
C2: 1uF; C_0603_HandSoldering
C3: ??uF; CP_Tantalum_Case-U_EIA-6032-15_Hand
J1: VIN; Socket_Strip_Straight_1x01_Pitch2.54mm
J2, J5: GND; Socket_Strip_Straight_1x01_Pitch2.54mm
J3: VOUT; Socket_Strip_Straight_1x01_Pitch2.54mm
J4: LDO; Socket_Strip_Straight_1x01_Pitch2.54mm
L1: 10uH; coilcraft-MSS5131-103
R1, R2, R3, R4, R5: R_Small; R_0603_HandSoldering
U1: LTC3105EMS-PBF

Connections:
GND: C1.2, C2.2, C3.2, J2.1, J5.1, R2.2, R4.2, R5.2, U1.6 (GND), U1.7 (GND)
LDO: J4.1, R3.1, U1.2 (LDO)
unnamed: C2.1, U1.12 (AUX)
unnamed: L1.1, U1.9 (SW)
unnamed: R1.2, R2.1, U1.1 (FB)
unnamed: R3.2, R4.1, U1.3 (FBLDO)
unnamed: R5.1, U1.5 (MPPC)
VIN: C3.1, J1.1, L1.2, U1.8 (VIN)
VOUT: C1.1, J3.1, R1.1, U1.11 (VOUT)

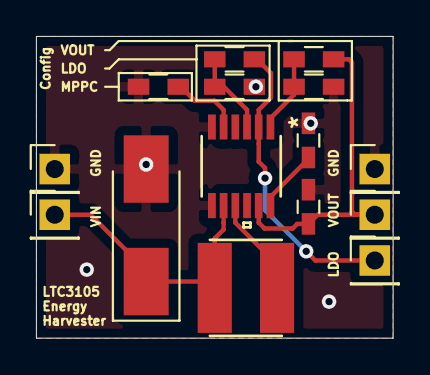
[picture p18: board ModuleSolarToStorageLTC3105.kicad_pcb from above]

Board: 2 copper layers, 19.8 x 16.8 mm, 15 parts (0 on the bottom side), 9 nets.
