aeronerd/KiCad/projects/BreakoutLTC3105/BreakoutLTC3105.kicad_pcb

## KiCad design projects/BreakoutLTC3105/BreakoutLTC3105.kicad_pcb (2019-02-19)

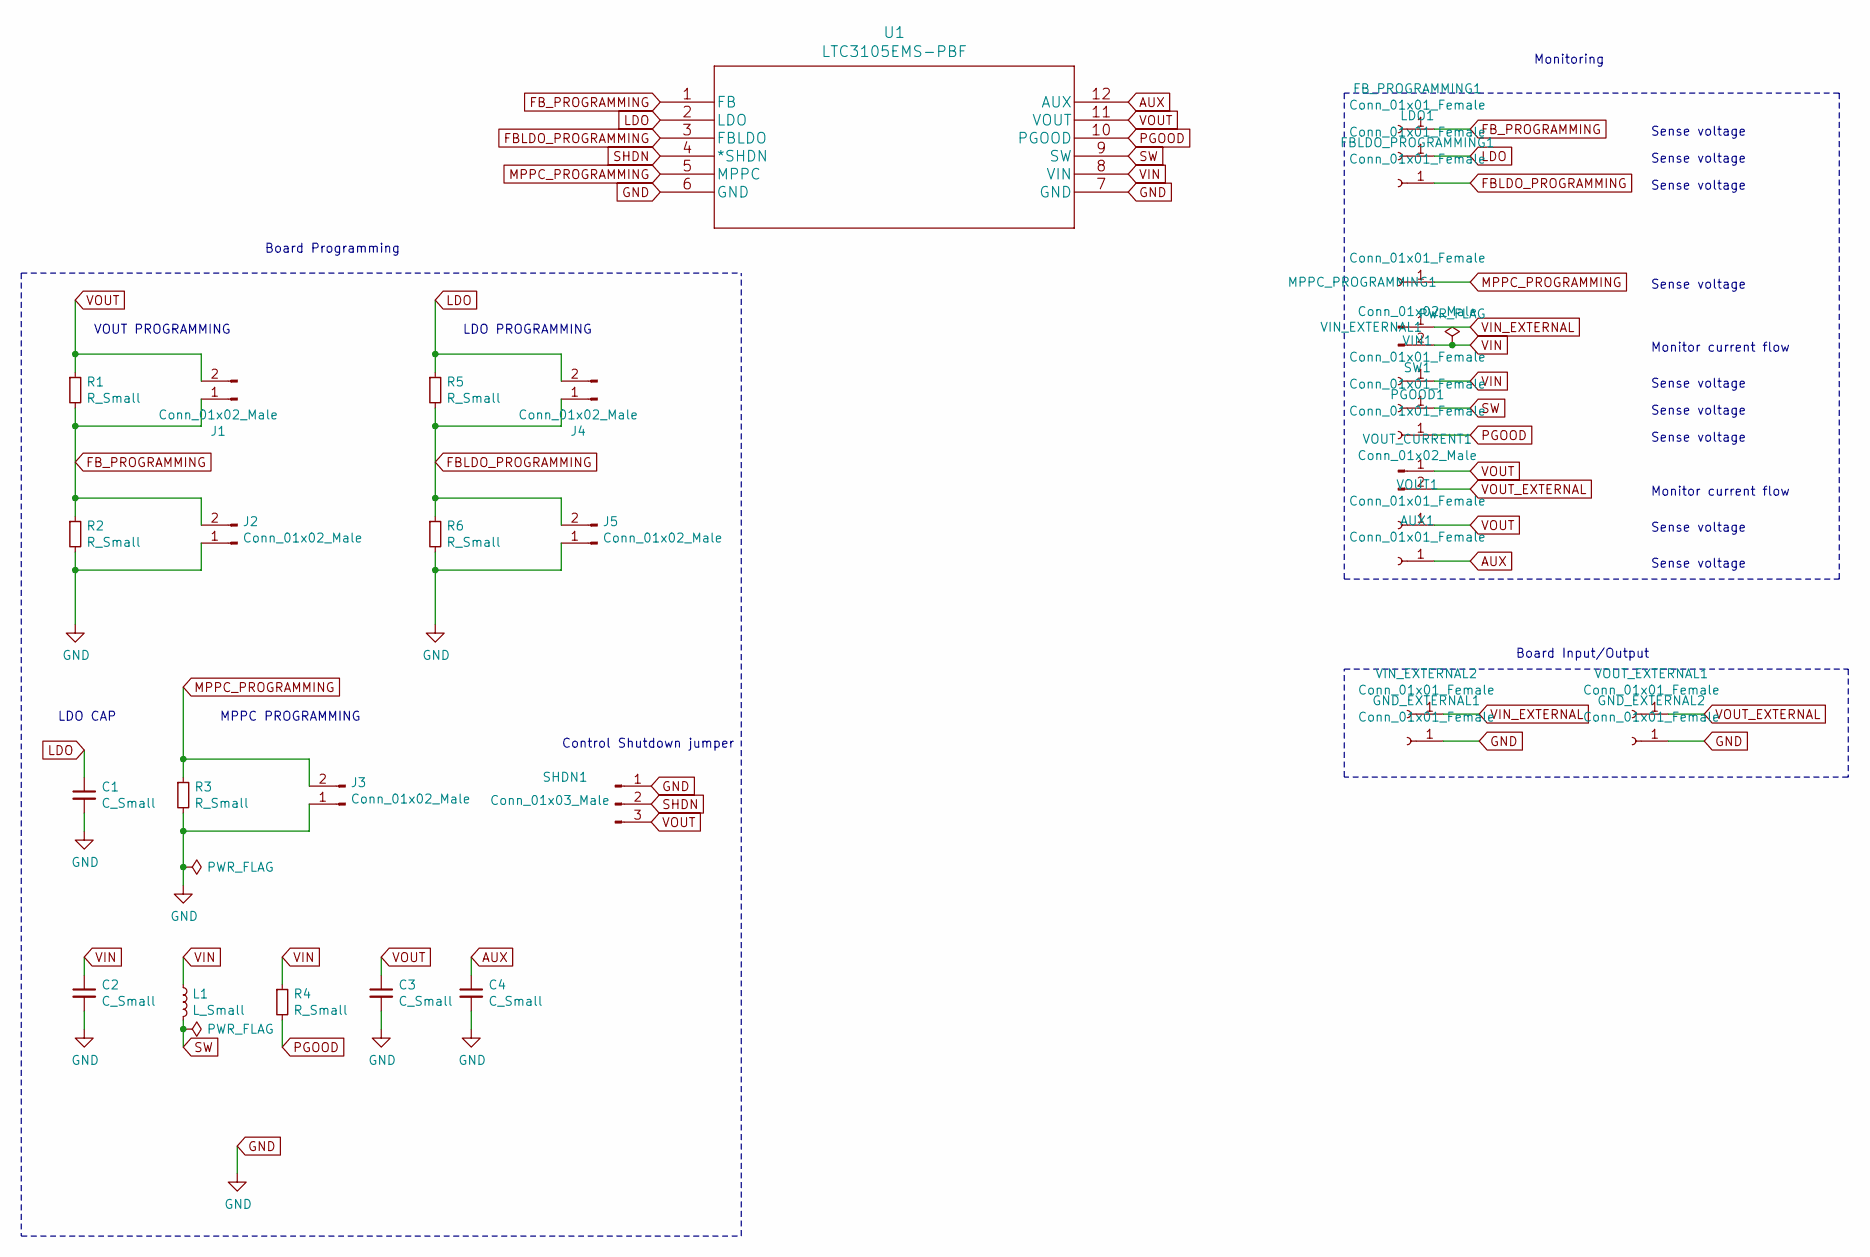
[picture p19: schematic BreakoutLTC3105.sch]

Parts:
AUX1: Conn_01x01_Female; Socket_Strip_Straight_1x01_Pitch2.54mm
C1, C2, C3, C4: C_Small; C_0603_HandSoldering
FBLDO_PROGRAMMING1: Conn_01x01_Female; Socket_Strip_Straight_1x01_Pitch2.54mm
FB_PROGRAMMING1: Conn_01x01_Female; Socket_Strip_Straight_1x01_Pitch2.54mm
GND_EXTERNAL1, GND_EXTERNAL2: Conn_01x01_Female; Socket_Strip_Straight_1x01_Pitch2.54mm
J1, J2, J3, J4, J5: Conn_01x02_Male; Pin_Header_Straight_1x02_Pitch2.54mm
L1: L_Small; coilcraft-MSS5131-103
LDO1: Conn_01x01_Female; Socket_Strip_Straight_1x01_Pitch2.54mm
MPPC_PROGRAMMING1: Conn_01x01_Female; Socket_Strip_Straight_1x01_Pitch2.54mm
PGOOD1: Conn_01x01_Female; Socket_Strip_Straight_1x01_Pitch2.54mm
R1, R2, R3, R4, R5, R6: R_Small; R_0603_HandSoldering
SHDN1: Conn_01x03_Male; Pin_Header_Straight_1x03_Pitch2.54mm
SW1: Conn_01x01_Female; Socket_Strip_Straight_1x01_Pitch2.54mm
U1: LTC3105EMS-PBF
VIN1: Conn_01x01_Female; Socket_Strip_Straight_1x01_Pitch2.54mm
VIN_EXTERNAL1: Conn_01x02_Male; Pin_Header_Straight_1x02_Pitch2.54mm
VIN_EXTERNAL2: Conn_01x01_Female; Socket_Strip_Straight_1x01_Pitch2.54mm
VOUT1: Conn_01x01_Female; Socket_Strip_Straight_1x01_Pitch2.54mm
VOUT_CURRENT1: Conn_01x02_Male; Pin_Header_Straight_1x02_Pitch2.54mm
VOUT_EXTERNAL1: Conn_01x01_Female; Socket_Strip_Straight_1x01_Pitch2.54mm

Connections:
AUX: AUX1.1, C4.1, U1.12 (AUX)
FBLDO_PROGRAMMING: FBLDO_PROGRAMMING1.1, J4.1, J5.2, R5.2, R6.1, U1.3 (FBLDO)
FB_PROGRAMMING: FB_PROGRAMMING1.1, J1.1, J2.2, R1.2, R2.1, U1.1 (FB)
GND: C1.2, C2.2, C3.2, C4.2, GND_EXTERNAL1.1, GND_EXTERNAL2.1, J2.1, J3.1, J5.1, R2.2, R3.2, R6.2, SHDN1.1, U1.6 (GND), U1.7 (GND)
LDO: C1.1, J4.2, LDO1.1, R5.1, U1.2 (LDO)
MPPC_PROGRAMMING: J3.2, MPPC_PROGRAMMING1.1, R3.1, U1.5 (MPPC)
PGOOD: PGOOD1.1, R4.2, U1.10 (PGOOD)
SHDN: SHDN1.2, U1.4 (*SHDN)
SW: L1.2, SW1.1, U1.9 (SW)
VIN: C2.1, L1.1, R4.1, U1.8 (VIN), VIN1.1, VIN_EXTERNAL1.2
VIN_EXTERNAL: VIN_EXTERNAL1.1, VIN_EXTERNAL2.1
VOUT: C3.1, J1.2, R1.1, SHDN1.3, U1.11 (VOUT), VOUT1.1, VOUT_CURRENT1.1
VOUT_EXTERNAL: VOUT_CURRENT1.2, VOUT_EXTERNAL1.1

Notes on the sheet:
VOUT PROGRAMMING
LDO CAP
LDO PROGRAMMING
Monitor current flow
Sense voltage
Monitoring
Control Shutdown jumper
Board Input/Output
Board Programming
MPPC PROGRAMMING

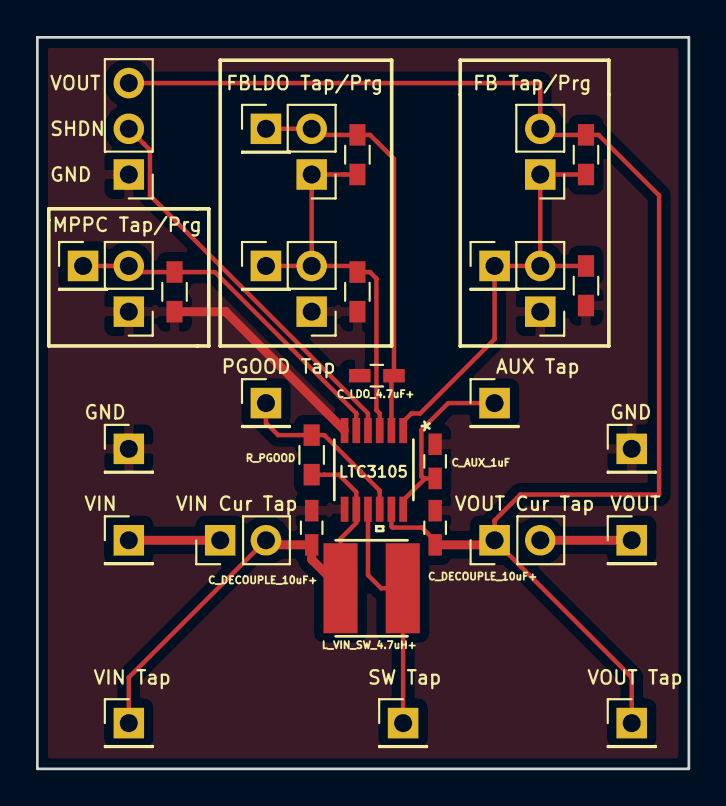
[picture p20: board BreakoutLTC3105.kicad_pcb from above]

Board: 2 copper layers, 36.2 x 40.6 mm, 33 parts (0 on the bottom side), 13 nets.
