aeronerd/KiCad/projects/BreakoutCAP1188/BreakoutCAP1188.kicad_pcb

## KiCad design projects/BreakoutCAP1188/BreakoutCAP1188.kicad_pcb (2018-09-30)

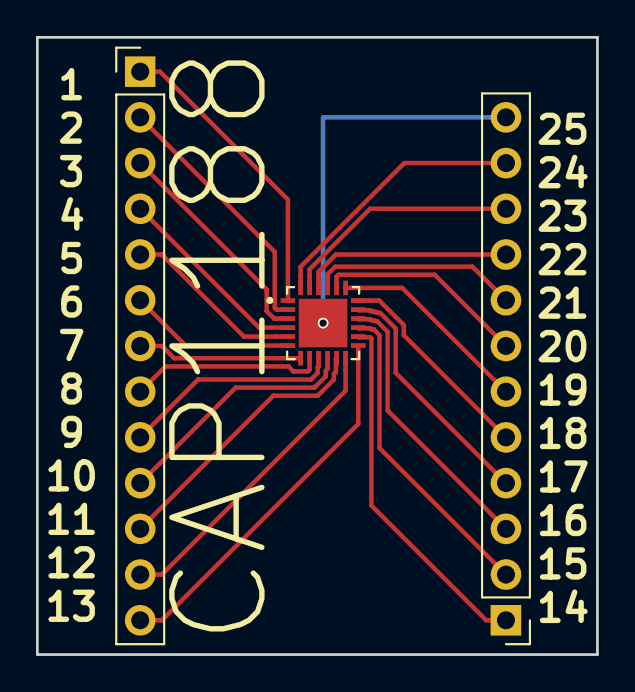
[picture p21: board BreakoutCAP1188.kicad_pcb from above]

Board: 2 copper layers, 31.1 x 34.3 mm, 3 parts (0 on the bottom side), 25 nets.

Parts:
J1: Conn_01x13; Pin_Header_Straight_1x13_Pitch2.54mm
J2: Conn_01x12; Pin_Header_Straight_1x12_Pitch2.54mm
U1: CAP1188; QFN50P400X400X90-25N

Connections:
unnamed: J1.1, U1.1
unnamed: J1.2, U1.2
unnamed: J1.3, U1.3
unnamed: J1.4, U1.4
unnamed: J1.5, U1.5
unnamed: J1.6, U1.6
unnamed: J1.7, U1.7
unnamed: J1.8, U1.8
unnamed: J1.9, U1.9
unnamed: J1.10, U1.10
unnamed: J1.11, U1.11
unnamed: J1.12, U1.12
unnamed: J1.13, U1.13
unnamed: J2.1, U1.14
unnamed: J2.2, U1.15
unnamed: J2.3, U1.16
unnamed: J2.4, U1.17
unnamed: J2.5, U1.18
unnamed: J2.6, U1.19
unnamed: J2.7, U1.20
unnamed: J2.8, U1.21
unnamed: J2.9, U1.22
unnamed: J2.10, U1.23
unnamed: J2.11, U1.24
unnamed: J2.12, U1.25
