aeronerd/KiCad/projects/BreakoutTPS6120XWithLayout/BreakoutTPS6120XWithLayout.kicad_pcb

## KiCad design projects/BreakoutTPS6120XWithLayout/BreakoutTPS6120XWithLayout.kicad_pcb (2018-06-05)

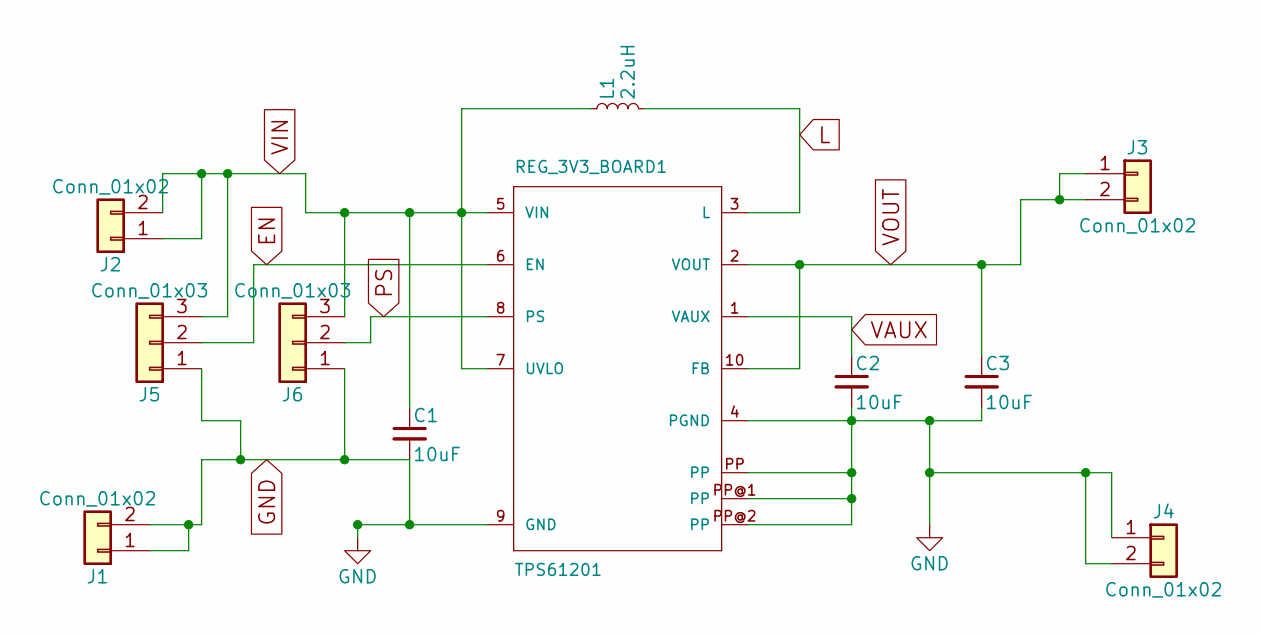
[picture p22: schematic BreakoutTPS6120XWithLayout.sch]

Parts:
C1, C2, C3: 10uF; C_0603_HandSoldering
J1, J2, J3, J4: Conn_01x02; Pin_Header_Straight_1x02_Pitch2.54mm
J5, J6: Conn_01x03; Pin_Header_Straight_1x03_Pitch2.54mm
L1: 2.2uH; coilcraft-LPS3015-222
REG_3V3_BOARD1: TPS61201; texas-S-PDSO-N10

Connections:
EN: J5.2, REG_3V3_BOARD1.6 (EN)
GND: C1.2, C2.2, C3.2, J1.1, J1.2, J4.1, J4.2, J5.1, J6.1, REG_3V3_BOARD1.4 (PGND), REG_3V3_BOARD1.9 (GND), REG_3V3_BOARD1.PP, REG_3V3_BOARD1.PP@1 (PP), REG_3V3_BOARD1.PP@2 (PP)
L: L1.2, REG_3V3_BOARD1.3 (L)
PS: J6.2, REG_3V3_BOARD1.8 (PS)
VAUX: C2.1, REG_3V3_BOARD1.1 (VAUX)
VIN: C1.1, J2.1, J2.2, J5.3, J6.3, L1.1, REG_3V3_BOARD1.5 (VIN), REG_3V3_BOARD1.7 (UVLO)
VOUT: C3.1, J3.1, J3.2, REG_3V3_BOARD1.2 (VOUT), REG_3V3_BOARD1.10 (FB)

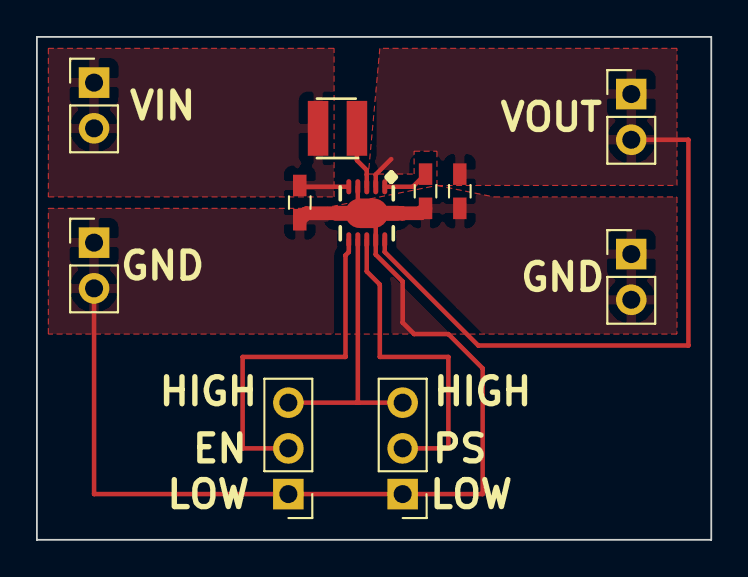
[picture p23: board BreakoutTPS6120XWithLayout.kicad_pcb from above]

Board: 2 copper layers, 37.5 x 27.9 mm, 11 parts (0 on the bottom side), 7 nets.
