aeronerd/KiCad/projects/PicoTrackerWSPR1/PicoTrackerWSPR1.kicad_pcb

## KiCad design projects/PicoTrackerWSPR1/PicoTrackerWSPR1.kicad_pcb (2018-04-15)

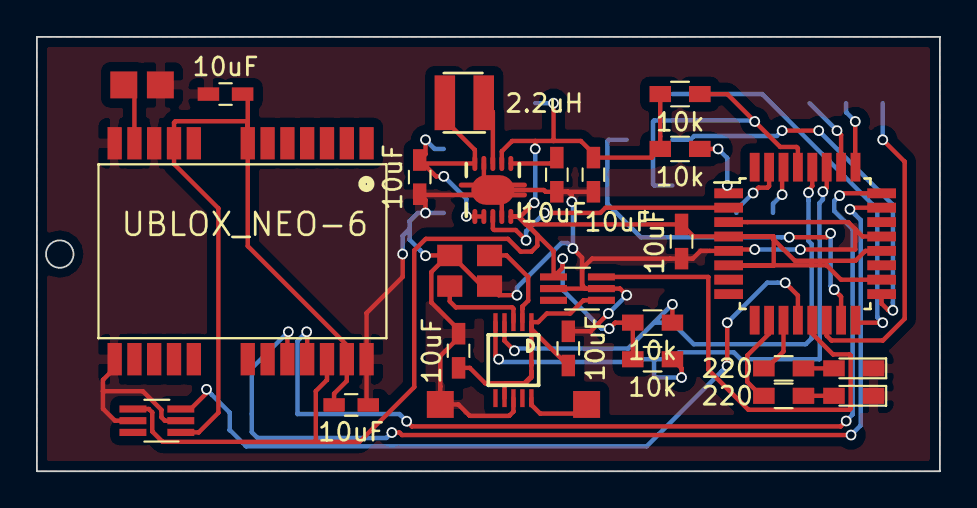
[picture p24: board PicoTrackerWSPR1.kicad_pcb from above]

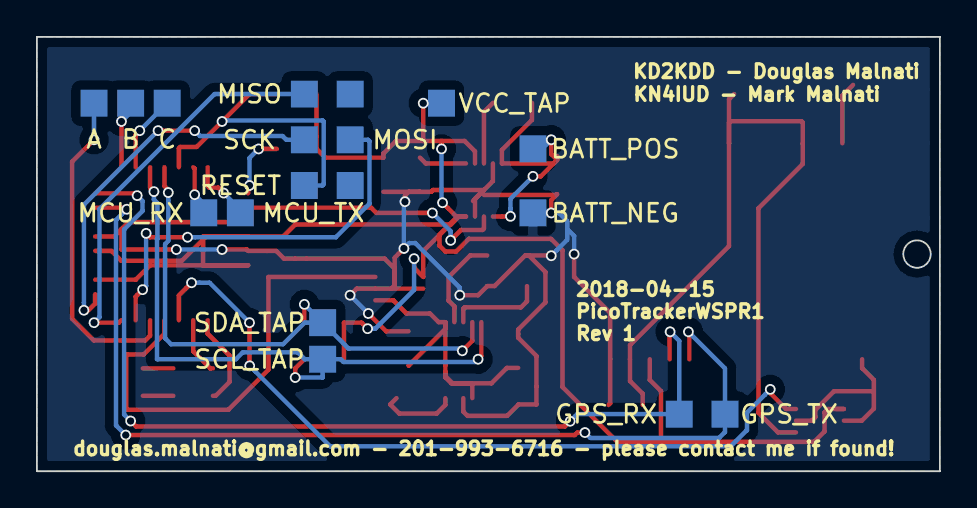
[picture p25: board PicoTrackerWSPR1.kicad_pcb from below]

Board: 2 copper layers, 50.2 x 24.1 mm, 46 parts (18 on the bottom side), 32 nets.

Parts:
C1, C2, C3, C4, C5, C6, C7, C8: 10uF; C_0603_HandSoldering
CONN1: BATT_POS; Measurement_Point_Square-SMD-Pad_Small
CONN2: BATT_NEG; Measurement_Point_Square-SMD-Pad_Small
CONN3: MCU_RX; Measurement_Point_Square-SMD-Pad_Small
CONN4: MCU_TX; Measurement_Point_Square-SMD-Pad_Small
CONN5: GPS_RF_GND; Measurement_Point_Square-SMD-Pad_Small
CONN6: GPS_RF_IN; Measurement_Point_Square-SMD-Pad_Small
CONN7: GPS_TX; Measurement_Point_Square-SMD-Pad_Small
CONN8: GPS_RX; Measurement_Point_Square-SMD-Pad_Small
CONN9: WSPR_RF_GND; Measurement_Point_Square-SMD-Pad_Small
CONN10: WSPR_RF_OUT; Measurement_Point_Square-SMD-Pad_Small
CONN11: A; Measurement_Point_Square-SMD-Pad_Small
CONN12: B; Measurement_Point_Square-SMD-Pad_Small
CONN13: C; Measurement_Point_Square-SMD-Pad_Small
CONN14: SCL_TAP; Measurement_Point_Square-SMD-Pad_Small
CONN15: SDA_TAP; Measurement_Point_Square-SMD-Pad_Small
CONN16: MISO; Measurement_Point_Square-SMD-Pad_Small
CONN17: SCK; Measurement_Point_Square-SMD-Pad_Small
CONN18: RESET; Measurement_Point_Square-SMD-Pad_Small
CONN19: VBATT; Measurement_Point_Square-SMD-Pad_Small
CONN20: MOSI; Measurement_Point_Square-SMD-Pad_Small
CONN21: GND; Measurement_Point_Square-SMD-Pad_Small
CONN22: VCC_TAP; Measurement_Point_Square-SMD-Pad_Small
D1, D2: LED_Small; LED_0603_HandSoldering
L1: 2.2uH; coilcraft-LPS3015-222
M1, M2: SIP32431DR3-T1GE3; SOT-363_SC-70-6_Handsoldering
M3: UBLOX_NEO-6
M4: SI5351A; MSOP10
R1, R2: 220; R_0603_HandSoldering
R3, R4, R5, R6: 10k; R_0603_HandSoldering
REG_3V3_BOARD1: TPS61201; texas-S-PDSO-N10
U1: ATMEGA328-AU; TQFP-32_7x7mm_Pitch0.8mm
Y1: CRYSTAL_ABM8G; ABM8G-25.000MHZ-B4Y-T

Connections:
GND: C1.2, C2.2, C3.2, C4.2, C5.2, C6.2, C7.1, C8.1, CONN2.1, CONN5.1, CONN9.1, D1.1, D2.1, M1.2, M1.5, M2.2, M2.5, M3.10_G, M3.12_G, M3.13_G, M3.24_G, M4.8, REG_3V3_BOARD1.4, REG_3V3_BOARD1.9, REG_3V3_BOARD1.PP, REG_3V3_BOARD1.PP@1, REG_3V3_BOARD1.PP@2, U1.3, U1.5, U1.21, Y1.2, Y1.4
GPS_ENABLE: M1.3, U1.12
GPS_RF_IN: CONN6.1, M3.11_R
GPS_SER_IN: CONN8.1, M3.21_R, U1.24
GPS_SER_OUT: CONN7.1, M3.20_T, U1.23
GPS_VCC: C5.1, C7.2, M1.1, M3.7_VD, M3.9_VC, M3.23_V
LED_1: R1.2, U1.10
LED_2: R2.2, U1.11
unnamed: C3.1, REG_3V3_BOARD1.1
unnamed: D1.2, R1.1
unnamed: D2.2, R2.1
unnamed: L1.2, REG_3V3_BOARD1.3
unnamed: M4.2, Y1.1
unnamed: M4.3, Y1.3
REG_PS_CTL: REG_3V3_BOARD1.8, U1.2
RESET: R3.2, U1.1
SCL: CONN15.1, M4.4, R5.2, U1.28
SDA: CONN14.1, M4.5, R4.2, U1.27
SER_RXD: CONN3.1, U1.30
SER_TXD: CONN4.1, U1.31
SIG_A: CONN11.1, U1.14
SIG_B: CONN12.1, U1.25
SIG_C: CONN13.1, U1.26
SPI_MISO: CONN16.1, U1.16
SPI_MOSI: CONN20.1, U1.15
SPI_RESET: CONN18.1, R6.2, U1.29
SPI_SCK: CONN17.1, U1.17
VBATT: C2.1, CONN1.1, L1.1, REG_3V3_BOARD1.5, REG_3V3_BOARD1.6, REG_3V3_BOARD1.7
VCC: C1.1, C4.1, CONN22.1, M1.4, M2.4, M3.22_V, R3.1, R4.1, R5.1, R6.1, REG_3V3_BOARD1.2, REG_3V3_BOARD1.10, U1.4, U1.6, U1.18, U1.20
WSPR_ENABLE: M2.3, U1.13
WSPR_RF_OUT: CONN10.1, M4.10
WSPR_VCC: C6.1, C8.2, M2.1, M4.1, M4.7
