aeronerd/KiCad/projects/PicoTracker1Rev2/PicoTracker1Rev2.kicad_pcb

## KiCad design projects/PicoTracker1Rev2/PicoTracker1Rev2.kicad_pcb (2018-03-24)

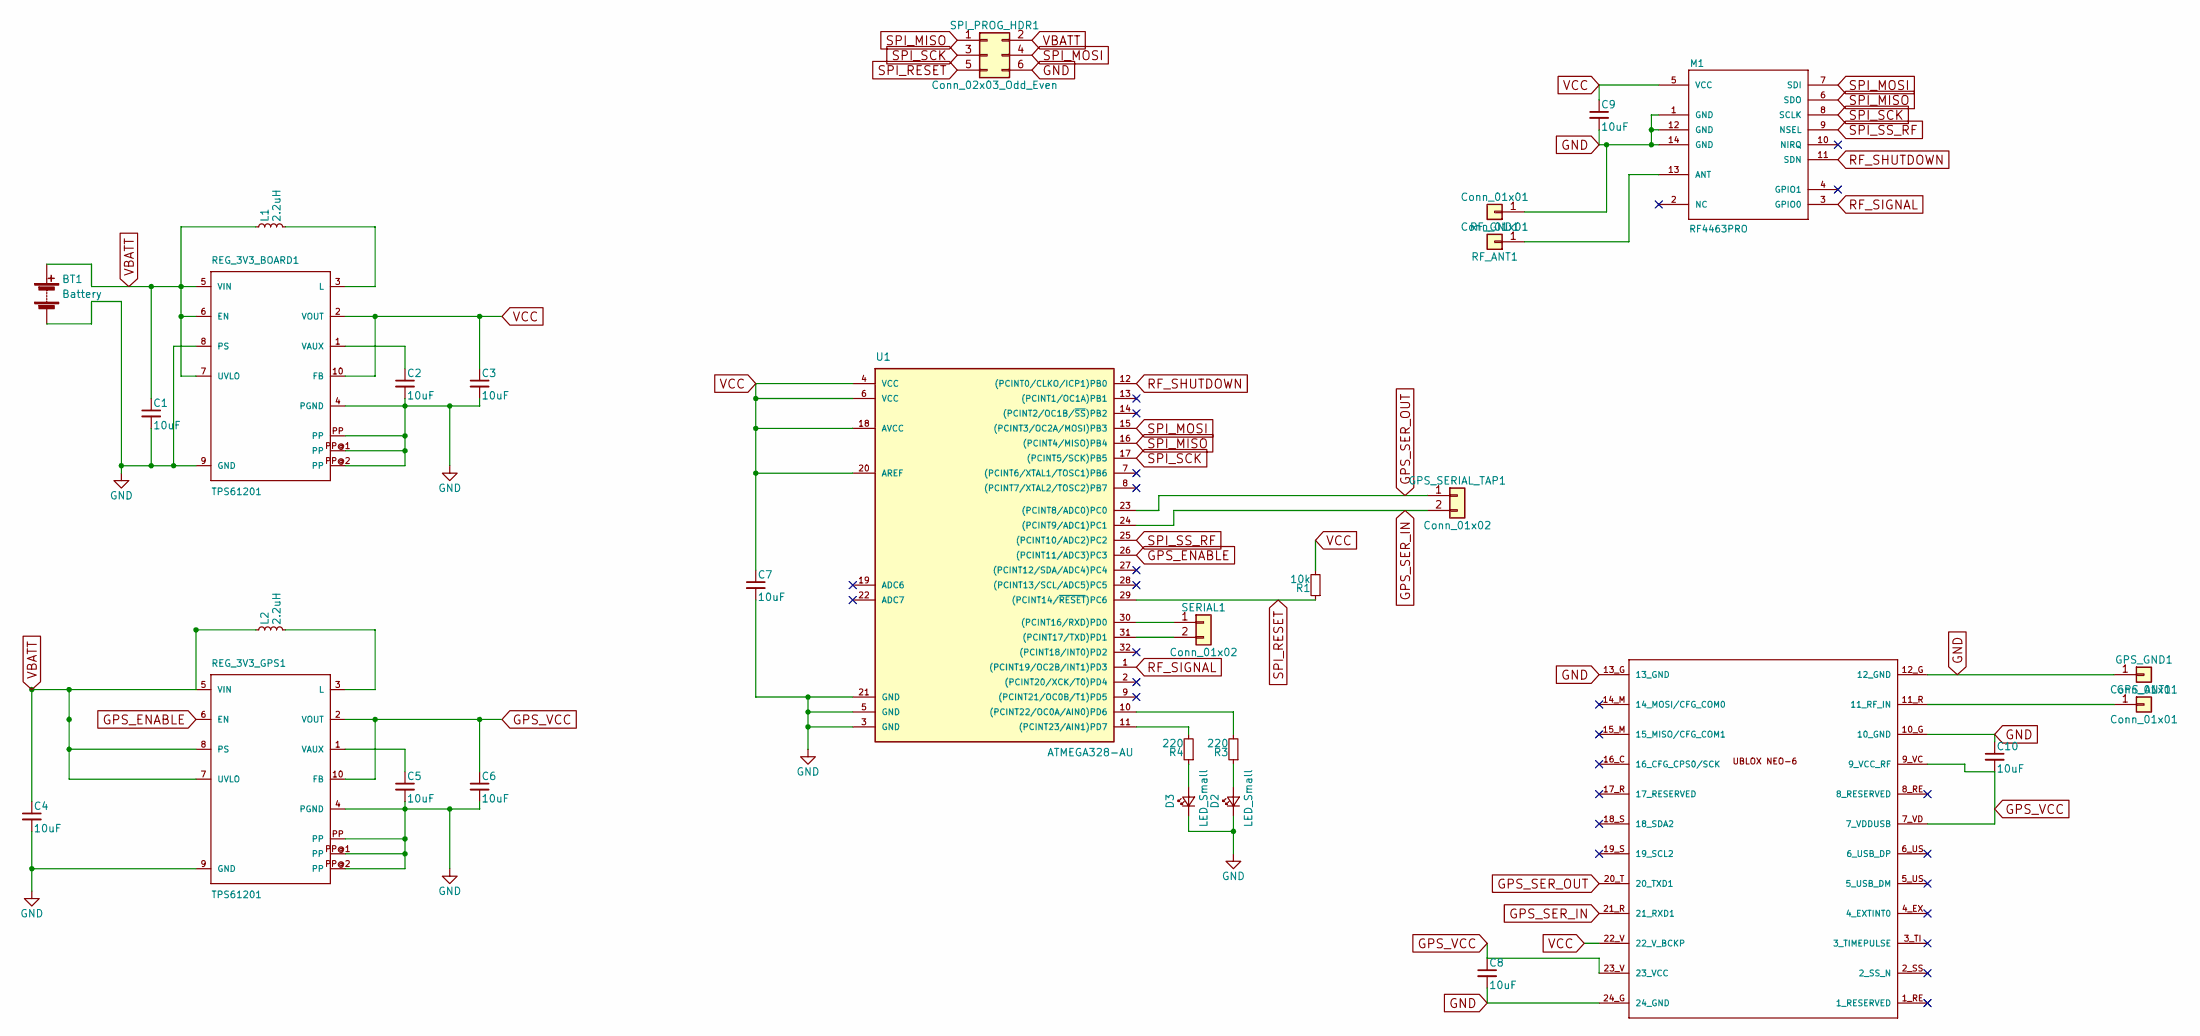
[picture p26: schematic PicoTracker1Rev2.sch]

Parts:
BT1: Battery; Pin_Header_Straight_1x02_Pitch2.54mm
C1, C2, C3, C4, C5, C6, C7, C8, C9, C10: 10uF; C_0603_HandSoldering
D2, D3: LED_Small; LED_0603_HandSoldering
GPS_ANT1: Conn_01x01; Measurement_Point_Square-SMD-Pad_Big
GPS_GND1: Conn_01x01; Measurement_Point_Square-SMD-Pad_Big
GPS_SERIAL_TAP1: Conn_01x02; Pin_Header_Straight_1x02_Pitch2.54mm
L1, L2: 2.2uH; L_0603_HandSoldering
M1: RF4463PRO; RF4436PRO-STD_BOARD
M2: UBLOX_NEO-6
R1: 10k; R_0603_HandSoldering
R3, R4: 220; R_0603_HandSoldering
REG_3V3_BOARD1, REG_3V3_GPS1: TPS61201; texas-S-PDSO-N10
RF_ANT1: Conn_01x01; Measurement_Point_Square-SMD-Pad_Big
RF_GND1: Conn_01x01; Measurement_Point_Square-SMD-Pad_Big
SERIAL1: Conn_01x02; Pin_Header_Straight_1x02_Pitch2.54mm
SPI_PROG_HDR1: Conn_02x03_Odd_Even; Pin_Header_Straight_2x03_Pitch2.54mm
U1: ATMEGA328-AU; TQFP-32_7x7mm_Pitch0.8mm

Connections:
GND: BT1.2 (-), C1.2, C2.2, C3.2, C4.2, C5.2, C6.2, C7.2, C8.2, C9.2, C10.1, D2.1 (K), D3.1 (K), GPS_GND1.1, M1.1 (GND), M1.12 (GND), M1.14 (GND), M2.10_G (10_GND), M2.12_G (12_GND), M2.13_G (13_GND), M2.24_G (24_GND), REG_3V3_BOARD1.4 (PGND), REG_3V3_BOARD1.8 (PS), REG_3V3_BOARD1.9 (GND), REG_3V3_BOARD1.PP, REG_3V3_BOARD1.PP@1 (PP), REG_3V3_BOARD1.PP@2 (PP), REG_3V3_GPS1.4 (PGND), REG_3V3_GPS1.9 (GND), REG_3V3_GPS1.PP, REG_3V3_GPS1.PP@1 (PP), REG_3V3_GPS1.PP@2 (PP), RF_GND1.1, SPI_PROG_HDR1.6, U1.3 (GND), U1.5 (GND), U1.21 (GND)
GPS_ENABLE: REG_3V3_GPS1.6 (EN), U1.26 ((PCINT11/ADC3)PC3)
GPS_SER_IN: GPS_SERIAL_TAP1.2, M2.21_R (21_RXD1), U1.24 ((PCINT9/ADC1)PC1)
GPS_SER_OUT: GPS_SERIAL_TAP1.1, M2.20_T (20_TXD1), U1.23 ((PCINT8/ADC0)PC0)
GPS_VCC: C6.1, C8.1, C10.2, M2.7_VD (7_VDDUSB), M2.9_VC (9_VCC_RF), M2.23_V (23_VCC), REG_3V3_GPS1.2 (VOUT), REG_3V3_GPS1.10 (FB)
unnamed: C2.1, REG_3V3_BOARD1.1 (VAUX)
unnamed: C5.1, REG_3V3_GPS1.1 (VAUX)
unnamed: D2.2 (A), R3.1
unnamed: D3.2 (A), R4.1
unnamed: GPS_ANT1.1, M2.11_R (11_RF_IN)
unnamed: L1.2, REG_3V3_BOARD1.3 (L)
unnamed: L2.2, REG_3V3_GPS1.3 (L)
unnamed: M1.13 (ANT), RF_ANT1.1
unnamed: R3.2, U1.10 ((PCINT22/OC0A/AIN0)PD6)
unnamed: R4.2, U1.11 ((PCINT23/AIN1)PD7)
unnamed: SERIAL1.1, U1.30 ((PCINT16/RXD)PD0)
unnamed: SERIAL1.2, U1.31 ((PCINT17/TXD)PD1)
RF_SHUTDOWN: M1.11 (SDN), U1.12 ((PCINT0/CLKO/ICP1)PB0)
RF_SIGNAL: M1.3 (GPIO0), U1.1 ((PCINT19/OC2B/INT1)PD3)
SPI_MISO: M1.6 (SDO), SPI_PROG_HDR1.1, U1.16 ((PCINT4/MISO)PB4)
SPI_MOSI: M1.7 (SDI), SPI_PROG_HDR1.4, U1.15 ((PCINT3/OC2A/MOSI)PB3)
SPI_RESET: R1.1, SPI_PROG_HDR1.5, U1.29 ((PCINT14/~RESET~)PC6)
SPI_SCK: M1.8 (SCLK), SPI_PROG_HDR1.3, U1.17 ((PCINT5/SCK)PB5)
SPI_SS_RF: M1.9 (NSEL), U1.25 ((PCINT10/ADC2)PC2)
VBATT: BT1.1 (+), C1.1, C4.1, L1.1, L2.1, REG_3V3_BOARD1.5 (VIN), REG_3V3_BOARD1.6 (EN), REG_3V3_BOARD1.7 (UVLO), REG_3V3_GPS1.5 (VIN), REG_3V3_GPS1.7 (UVLO), REG_3V3_GPS1.8 (PS), SPI_PROG_HDR1.2
VCC: C3.1, C7.1, C9.1, M1.5 (VCC), M2.22_V (22_V_BCKP), R1.2, REG_3V3_BOARD1.2 (VOUT), REG_3V3_BOARD1.10 (FB), U1.4 (VCC), U1.6 (VCC), U1.18 (AVCC), U1.20 (AREF)

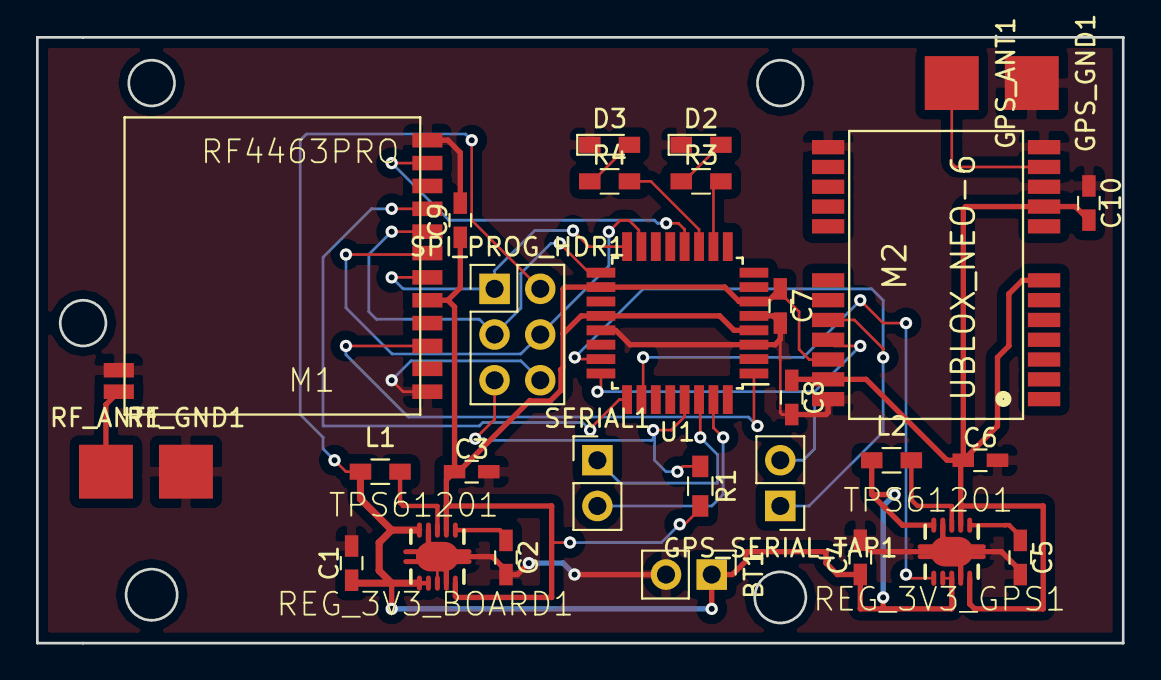
[picture p27: board PicoTracker1Rev2.kicad_pcb from above]

Board: 2 copper layers, 60.3 x 33.7 mm, 30 parts (0 on the bottom side), 26 nets.
