aeronerd/KiCad/projects/BreakoutTPS6120X/BreakoutTPS6120X.kicad_pcb

## KiCad design projects/BreakoutTPS6120X/BreakoutTPS6120X.kicad_pcb (2018-03-22)

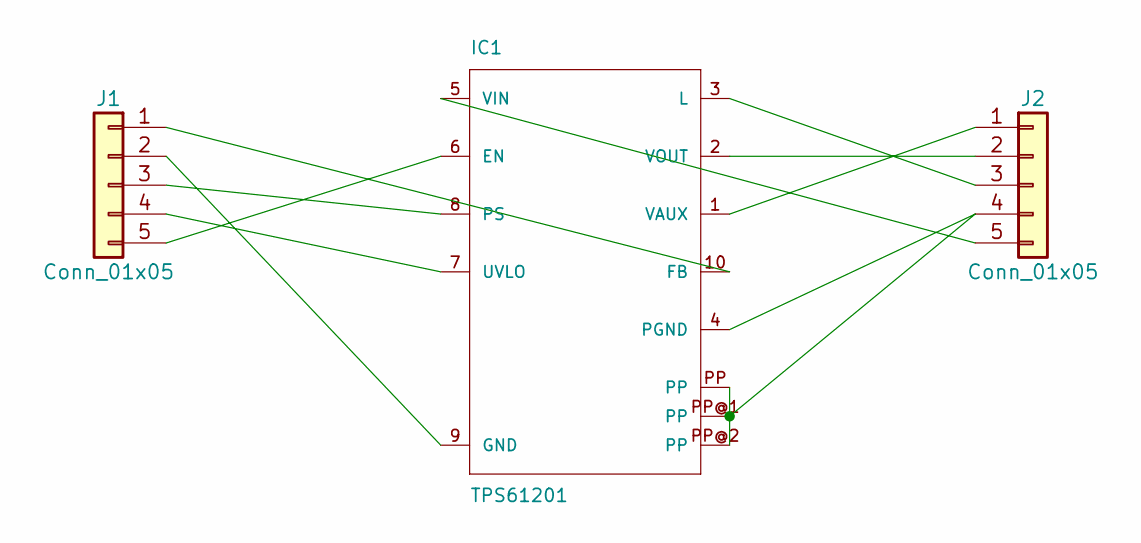
[picture p28: schematic BreakoutTPS6120X.sch]

Parts:
IC1: TPS61201; texas-S-PDSO-N10
J1, J2: Conn_01x05; Pin_Header_Straight_1x05_Pitch2.54mm

Connections:
unnamed: IC1.1 (VAUX), J2.1
unnamed: IC1.2 (VOUT), J2.2
unnamed: IC1.3 (L), J2.3
unnamed: IC1.4 (PGND), IC1.PP, IC1.PP@1 (PP), IC1.PP@2 (PP), J2.4
unnamed: IC1.5 (VIN), J2.5
unnamed: IC1.6 (EN), J1.5
unnamed: IC1.7 (UVLO), J1.4
unnamed: IC1.8 (PS), J1.3
unnamed: IC1.9 (GND), J1.2
unnamed: IC1.10 (FB), J1.1

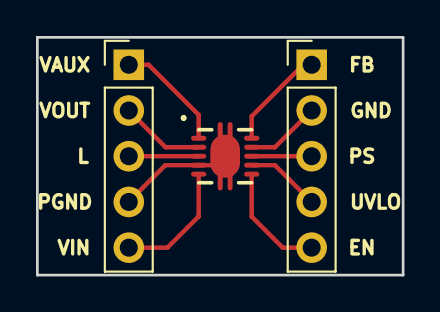
[picture p29: board BreakoutTPS6120X.kicad_pcb from above]

Board: 2 copper layers, 20.3 x 13.2 mm, 3 parts (0 on the bottom side), 10 nets.
