aeronerd/KiCad/projects/BreakoutSI4463PRO/BreakoutSI4463PRO.kicad_pcb

## KiCad design projects/BreakoutSI4463PRO/BreakoutSI4463PRO.kicad_pcb (2018-03-22)

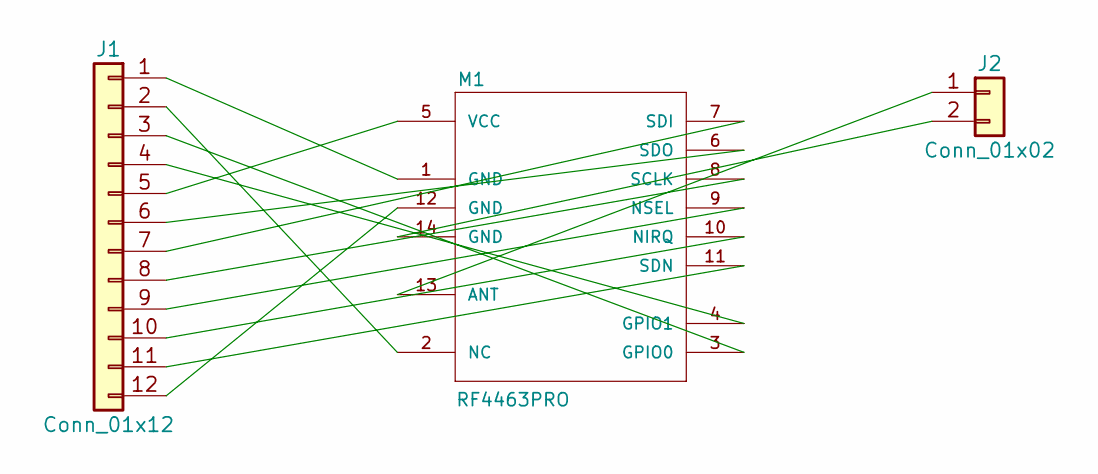
[picture p30: schematic BreakoutSI4463PRO.sch]

Parts:
J1: Conn_01x12; Pin_Header_Straight_1x12_Pitch2.54mm
J2: Conn_01x02; Pin_Header_Straight_1x02_Pitch2.54mm
M1: RF4463PRO; RF4436PRO-STD_BOARD

Connections:
unnamed: J1.1, M1.1 (GND)
unnamed: J1.2, M1.2 (NC)
unnamed: J1.3, M1.3 (GPIO0)
unnamed: J1.4, M1.4 (GPIO1)
unnamed: J1.5, M1.5 (VCC)
unnamed: J1.6, M1.6 (SDO)
unnamed: J1.7, M1.7 (SDI)
unnamed: J1.8, M1.8 (SCLK)
unnamed: J1.9, M1.9 (NSEL)
unnamed: J1.10, M1.10 (NIRQ)
unnamed: J1.11, M1.11 (SDN)
unnamed: J1.12, M1.12 (GND)
unnamed: J2.1, M1.13 (ANT)
unnamed: J2.2, M1.14 (GND)

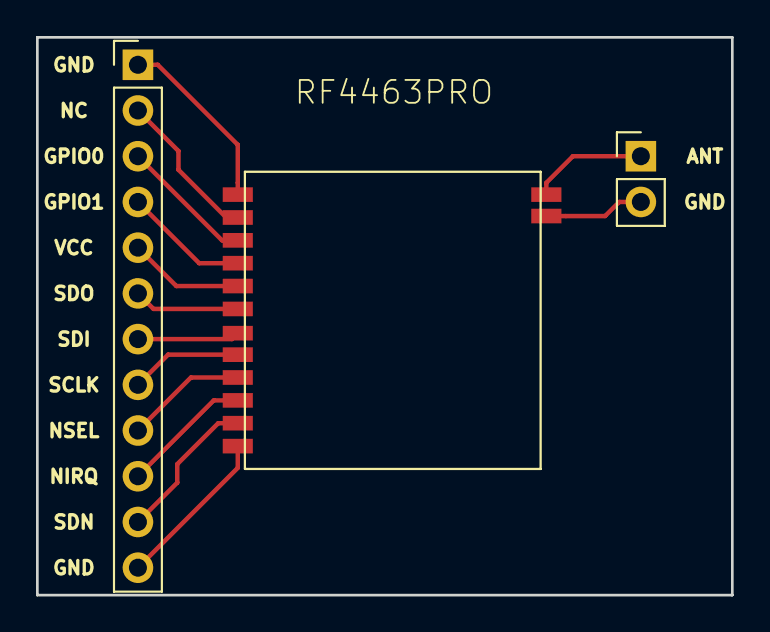
[picture p31: board BreakoutSI4463PRO.kicad_pcb from above]

Board: 2 copper layers, 38.6 x 31.0 mm, 3 parts (0 on the bottom side), 14 nets.
