aeronerd/KiCad/projects/BreakoutSI4463/BreakoutSI4463.kicad_pcb

## KiCad design projects/BreakoutSI4463/BreakoutSI4463.kicad_pcb (2018-02-18)

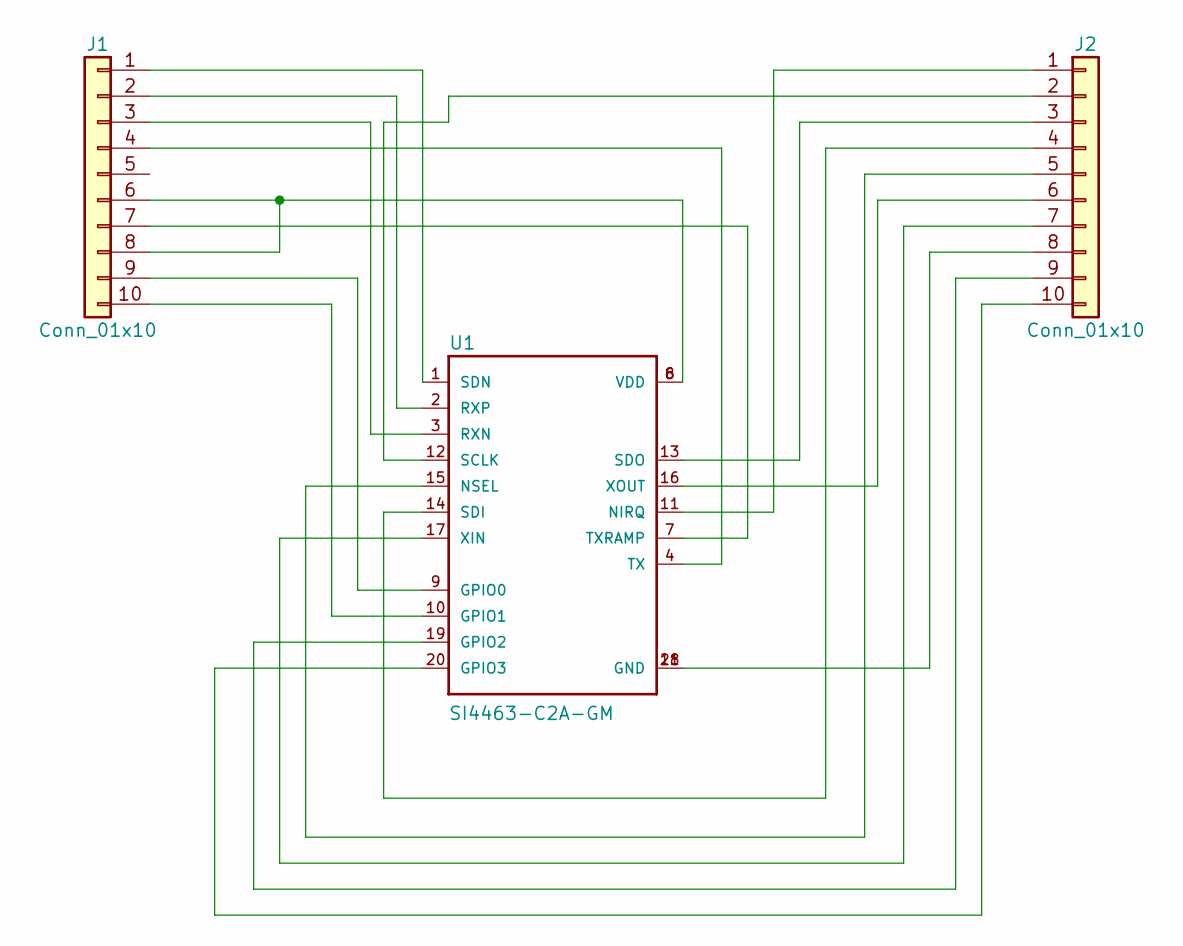
[picture p32: schematic BreakoutSI4463.sch]

Parts:
J1, J2: Conn_01x10; Pin_Header_Straight_1x10_Pitch2.54mm
U1: SI4463-C2A-GM; QFN50P400X400X90-20N

Connections:
unnamed: J1.1, U1.1 (SDN)
unnamed: J1.2, U1.2 (RXP)
unnamed: J1.3, U1.3 (RXN)
unnamed: J1.4, U1.4 (TX)
unnamed: J1.6, J1.8, U1.6 (VDD), U1.8 (VDD)
unnamed: J1.7, U1.7 (TXRAMP)
unnamed: J1.9, U1.9 (GPIO0)
unnamed: J1.10, U1.10 (GPIO1)
unnamed: J2.1, U1.11 (NIRQ)
unnamed: J2.2, U1.12 (SCLK)
unnamed: J2.3, U1.13 (SDO)
unnamed: J2.4, U1.14 (SDI)
unnamed: J2.5, U1.15 (NSEL)
unnamed: J2.6, U1.16 (XOUT)
unnamed: J2.7, U1.17 (XIN)
unnamed: J2.8, U1.18 (GND), U1.21 (GND)
unnamed: J2.9, U1.19 (GPIO2)
unnamed: J2.10, U1.20 (GPIO3)

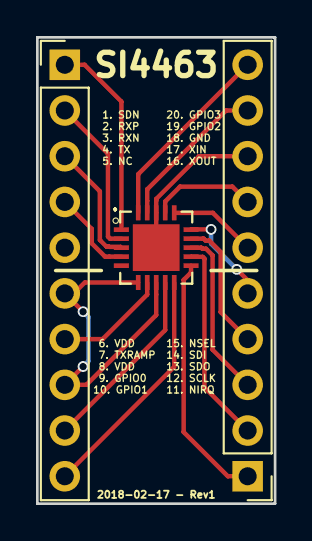
[picture p33: board BreakoutSI4463.kicad_pcb from above]

Board: 2 copper layers, 13.2 x 25.9 mm, 3 parts (0 on the bottom side), 18 nets.
