aeronerd/KiCad/projects/BreakoutUblox/BreakoutUblox.kicad_pcb

## KiCad design projects/BreakoutUblox/BreakoutUblox.kicad_pcb (2018-02-18)

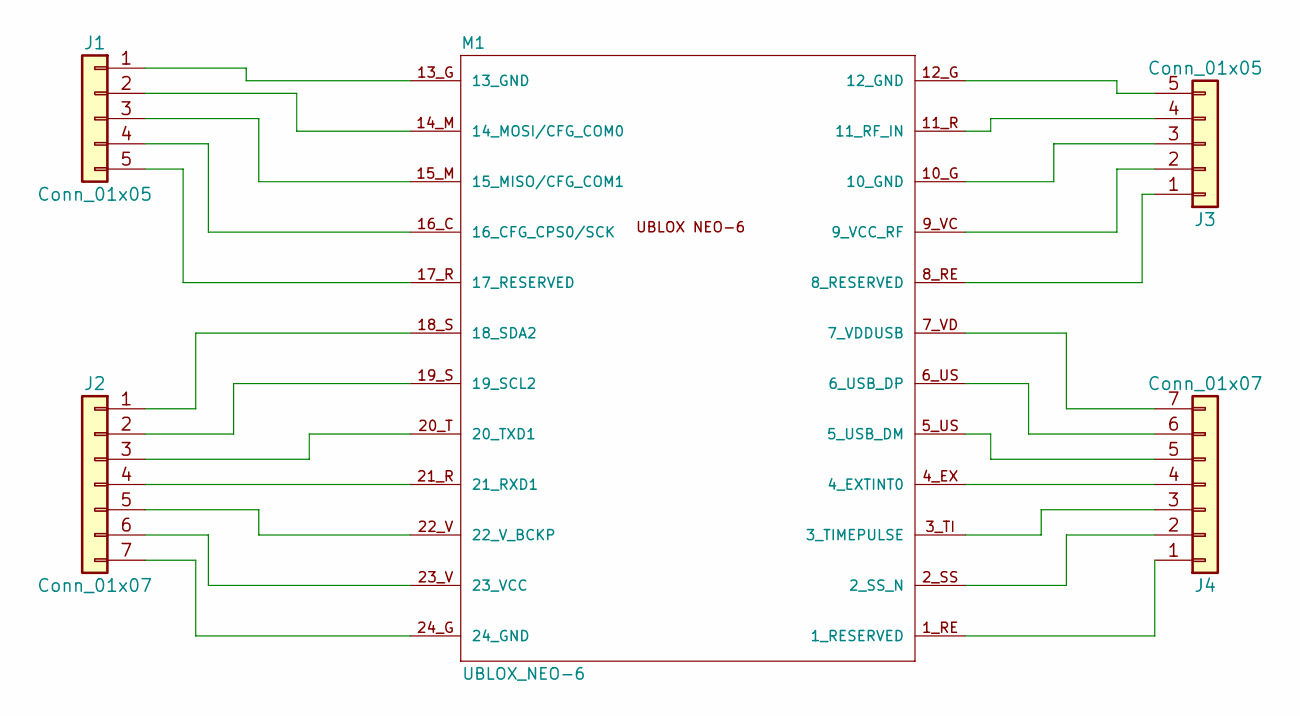
[picture p34: schematic BreakoutUblox.sch]

Parts:
J1, J3: Conn_01x05; Pin_Header_Straight_1x05_Pitch2.54mm
J2, J4: Conn_01x07; Pin_Header_Straight_1x07_Pitch2.54mm
M1: UBLOX_NEO-6

Connections:
unnamed: J1.1, M1.13_G (13_GND)
unnamed: J1.2, M1.14_M (14_MOSI/CFG_COM0)
unnamed: J1.3, M1.15_M (15_MISO/CFG_COM1)
unnamed: J1.4, M1.16_C (16_CFG_CPS0/SCK)
unnamed: J1.5, M1.17_R (17_RESERVED)
unnamed: J2.1, M1.18_S (18_SDA2)
unnamed: J2.2, M1.19_S (19_SCL2)
unnamed: J2.3, M1.20_T (20_TXD1)
unnamed: J2.4, M1.21_R (21_RXD1)
unnamed: J2.5, M1.22_V (22_V_BCKP)
unnamed: J2.6, M1.23_V (23_VCC)
unnamed: J2.7, M1.24_G (24_GND)
unnamed: J3.1, M1.8_RE (8_RESERVED)
unnamed: J3.2, M1.9_VC (9_VCC_RF)
unnamed: J3.3, M1.10_G (10_GND)
unnamed: J3.4, M1.11_R (11_RF_IN)
unnamed: J3.5, M1.12_G (12_GND)
unnamed: J4.1, M1.1_RE (1_RESERVED)
unnamed: J4.2, M1.2_SS (2_SS_N)
unnamed: J4.3, M1.3_TI (3_TIMEPULSE)
unnamed: J4.4, M1.4_EX (4_EXTINT0)
unnamed: J4.5, M1.5_US (5_USB_DM)
unnamed: J4.6, M1.6_US (6_USB_DP)
unnamed: J4.7, M1.7_VD (7_VDDUSB)

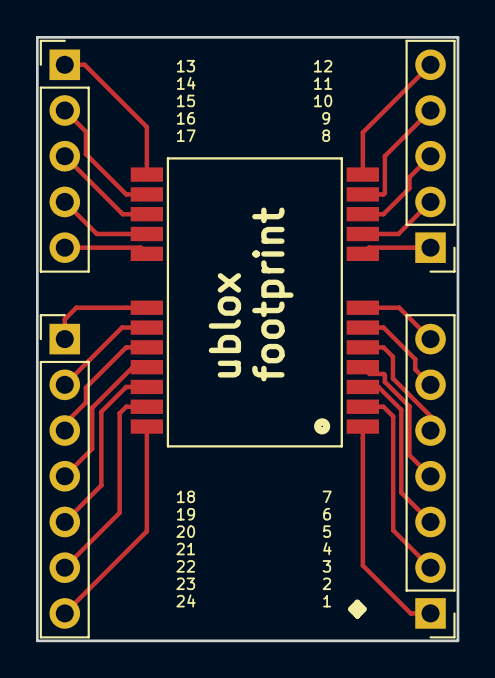
[picture p35: board BreakoutUblox.kicad_pcb from above]

Board: 2 copper layers, 23.4 x 33.5 mm, 5 parts (0 on the bottom side), 24 nets.
