aeronerd/KiCad/projects/EvilEye/EvilEye.kicad_pcb

## KiCad design projects/EvilEye/EvilEye.kicad_pcb (2018-10-21)

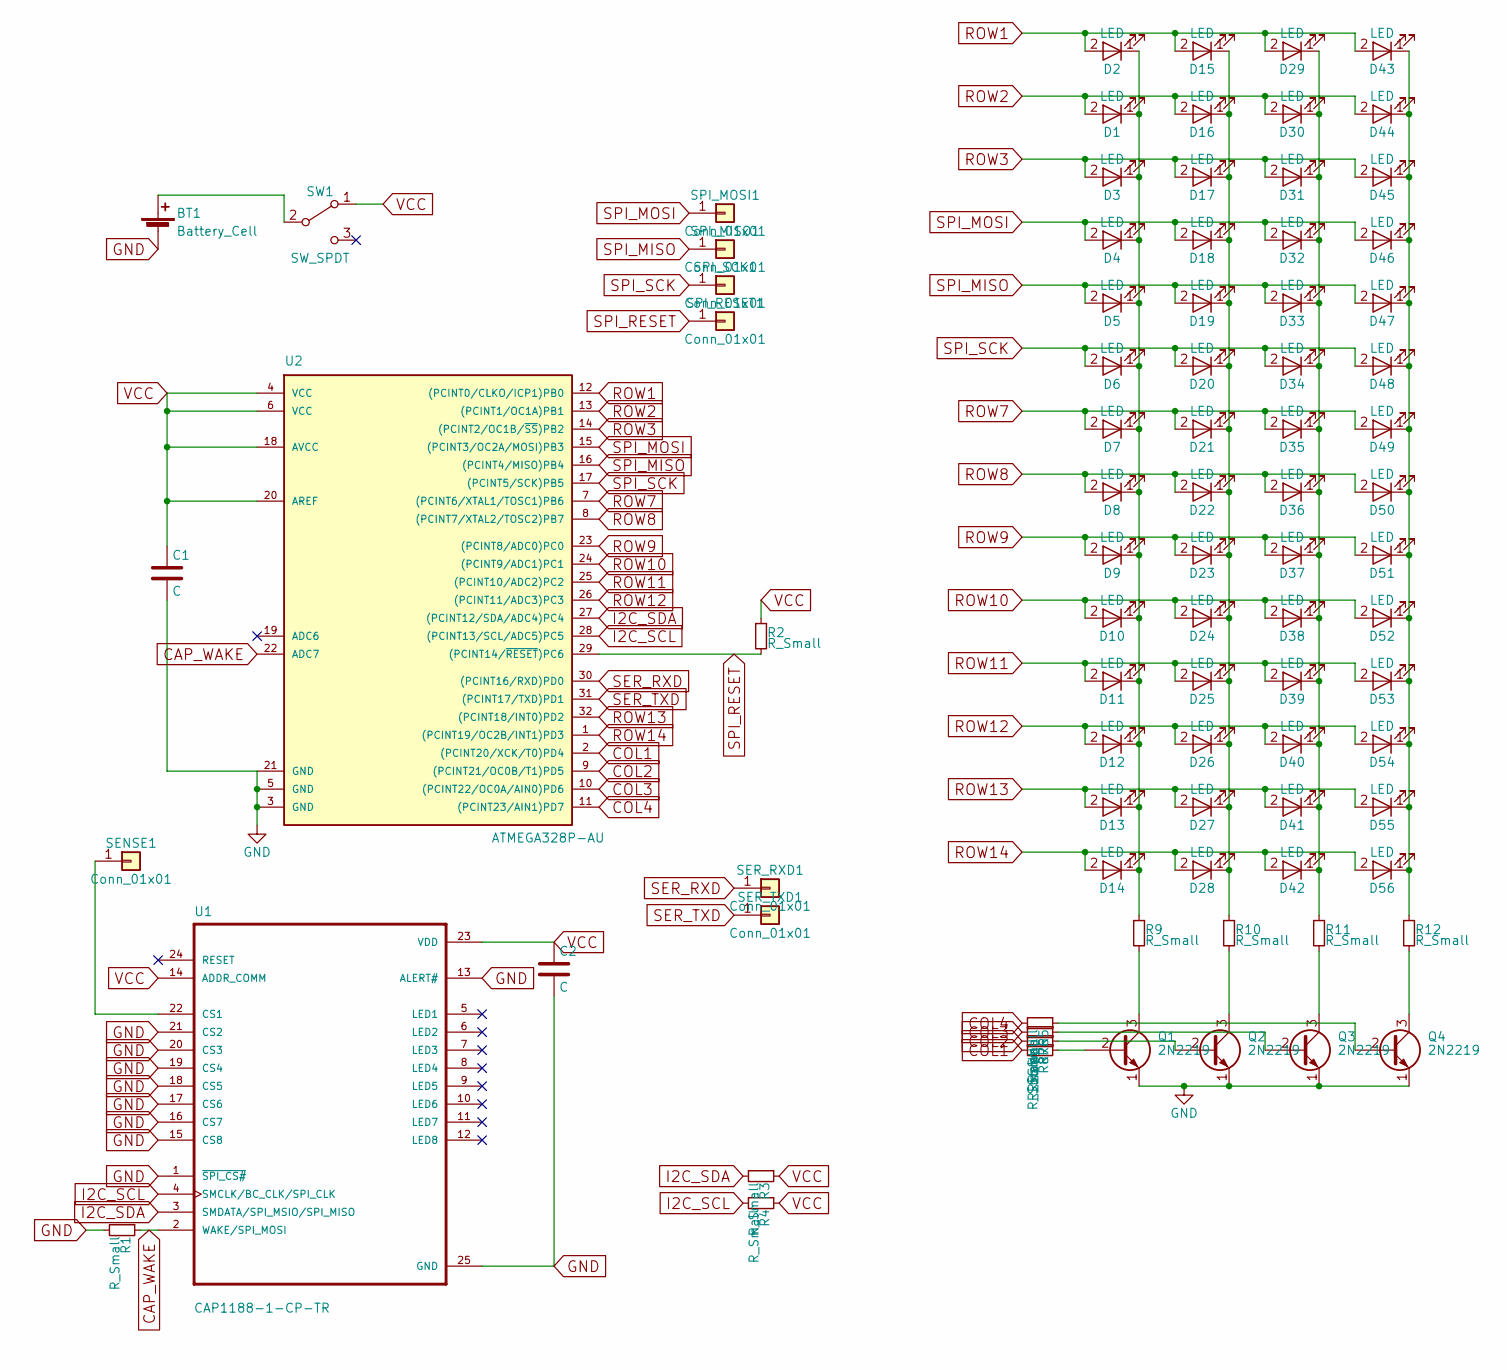
[picture p36: schematic _saved_EvilEye.sch]

Parts:
BT1: Battery_Cell; 2032-CoinCell-top-bottom
C1, C2: C; C_0603
D1, D2, D3, D4, D5, D6, D7, D8, D9, D10, D11, D12, D13, D14, D15, D16, D17, D18, D19, D20, D21, D22, D23, D24, D25, D26, D27, D28, D29, D30, D31, D32, D33, D34, D35, D36, D37, D38, D39, D40, D41, D42, D43, D44, D45, D46, D47, D48, D49, D50, D51, D52, D53, D54, D55, D56: LED; LED_1206
Q1, Q2, Q3, Q4: 2N2219; SOT23
R1, R2, R3, R4, R5, R6, R7, R8, R9, R10, R11, R12: R_Small; R_0603
SENSE1: Conn_01x01; Measurement_Point_Square-SMD-Pad_Small
SER_RXD1: Conn_01x01; Measurement_Point_Square-SMD-Pad_Small
SER_TXD1: Conn_01x01; Measurement_Point_Square-SMD-Pad_Small
SPI_MISO1: Conn_01x01; Measurement_Point_Square-SMD-Pad_Small
SPI_MOSI1: Conn_01x01; Measurement_Point_Square-SMD-Pad_Small
SPI_RESET1: Conn_01x01; Measurement_Point_Square-SMD-Pad_Small
SPI_SCK1: Conn_01x01; Measurement_Point_Square-SMD-Pad_Small
SW1: SW_SPDT; SW_SPDT_SMD
U1: CAP1188-1-CP-TR; QFN50P400X400X90-25N
U2: ATMEGA328P-AU; TQFP-32_7x7mm_Pitch0.8mm

Connections:
CAP_WAKE: R1.1, U1.2 (WAKE/SPI_MOSI), U2.22 (ADC7)
COL1: R8.2, U2.2 ((PCINT20/XCK/T0)PD4)
COL2: R7.2, U2.9 ((PCINT21/OC0B/T1)PD5)
COL3: R6.2, U2.10 ((PCINT22/OC0A/AIN0)PD6)
COL4: R5.2, U2.11 ((PCINT23/AIN1)PD7)
GND: BT1.2 (-), C1.2, C2.2, Q1.1 (E), Q2.1 (E), Q3.1 (E), Q4.1 (E), R1.2, U1.1 (~SPI_CS#~), U1.13 (ALERT#), U1.15 (CS8), U1.16 (CS7), U1.17 (CS6), U1.18 (CS5), U1.19 (CS4), U1.20 (CS3), U1.21 (CS2), U1.25 (GND), U2.3 (GND), U2.5 (GND), U2.21 (GND)
I2C_SCL: R4.2, U1.4 (SMCLK/BC_CLK/SPI_CLK), U2.28 ((PCINT13/SCL/ADC5)PC5)
I2C_SDA: R3.2, U1.3 (SMDATA/SPI_MSIO/SPI_MISO), U2.27 ((PCINT12/SDA/ADC4)PC4)
unnamed: BT1.1 (+), SW1.2 (B)
unnamed: D1.1 (K), D2.1 (K), D3.1 (K), D4.1 (K), D5.1 (K), D6.1 (K), D7.1 (K), D8.1 (K), D9.1 (K), D10.1 (K), D11.1 (K), D12.1 (K), D13.1 (K), D14.1 (K), R9.1
unnamed: D15.1 (K), D16.1 (K), D17.1 (K), D18.1 (K), D19.1 (K), D20.1 (K), D21.1 (K), D22.1 (K), D23.1 (K), D24.1 (K), D25.1 (K), D26.1 (K), D27.1 (K), D28.1 (K), R10.1
unnamed: D29.1 (K), D30.1 (K), D31.1 (K), D32.1 (K), D33.1 (K), D34.1 (K), D35.1 (K), D36.1 (K), D37.1 (K), D38.1 (K), D39.1 (K), D40.1 (K), D41.1 (K), D42.1 (K), R11.1
unnamed: D43.1 (K), D44.1 (K), D45.1 (K), D46.1 (K), D47.1 (K), D48.1 (K), D49.1 (K), D50.1 (K), D51.1 (K), D52.1 (K), D53.1 (K), D54.1 (K), D55.1 (K), D56.1 (K), R12.1
unnamed: Q1.2 (B), R8.1
unnamed: Q1.3 (C), R9.2
unnamed: Q2.2 (B), R7.1
unnamed: Q2.3 (C), R10.2
unnamed: Q3.2 (B), R6.1
unnamed: Q3.3 (C), R11.2
unnamed: Q4.2 (B), R5.1
unnamed: Q4.3 (C), R12.2
unnamed: SENSE1.1, U1.22 (CS1)
ROW1: D2.2 (A), D15.2 (A), D29.2 (A), D43.2 (A), U2.12 ((PCINT0/CLKO/ICP1)PB0)
ROW2: D1.2 (A), D16.2 (A), D30.2 (A), D44.2 (A), U2.13 ((PCINT1/OC1A)PB1)
ROW3: D3.2 (A), D17.2 (A), D31.2 (A), D45.2 (A), U2.14 ((PCINT2/OC1B/~SS~)PB2)
ROW7: D7.2 (A), D21.2 (A), D35.2 (A), D49.2 (A), U2.7 ((PCINT6/XTAL1/TOSC1)PB6)
ROW8: D8.2 (A), D22.2 (A), D36.2 (A), D50.2 (A), U2.8 ((PCINT7/XTAL2/TOSC2)PB7)
ROW9: D9.2 (A), D23.2 (A), D37.2 (A), D51.2 (A), U2.23 ((PCINT8/ADC0)PC0)
ROW10: D10.2 (A), D24.2 (A), D38.2 (A), D52.2 (A), U2.24 ((PCINT9/ADC1)PC1)
ROW11: D11.2 (A), D25.2 (A), D39.2 (A), D53.2 (A), U2.25 ((PCINT10/ADC2)PC2)
ROW12: D12.2 (A), D26.2 (A), D40.2 (A), D54.2 (A), U2.26 ((PCINT11/ADC3)PC3)
ROW13: D13.2 (A), D27.2 (A), D41.2 (A), D55.2 (A), U2.32 ((PCINT18/INT0)PD2)
ROW14: D14.2 (A), D28.2 (A), D42.2 (A), D56.2 (A), U2.1 ((PCINT19/OC2B/INT1)PD3)
SER_RXD: SER_RXD1.1, U2.30 ((PCINT16/RXD)PD0)
SER_TXD: SER_TXD1.1, U2.31 ((PCINT17/TXD)PD1)
SPI_MISO: D5.2 (A), D19.2 (A), D33.2 (A), D47.2 (A), SPI_MISO1.1, U2.16 ((PCINT4/MISO)PB4)
SPI_MOSI: D4.2 (A), D18.2 (A), D32.2 (A), D46.2 (A), SPI_MOSI1.1, U2.15 ((PCINT3/OC2A/MOSI)PB3)
SPI_RESET: R2.2, SPI_RESET1.1, U2.29 ((PCINT14/~RESET~)PC6)
SPI_SCK: D6.2 (A), D20.2 (A), D34.2 (A), D48.2 (A), SPI_SCK1.1, U2.17 ((PCINT5/SCK)PB5)
VCC: C1.1, C2.1, R2.1, R3.1, R4.1, SW1.1 (A), U1.14 (ADDR_COMM), U1.23 (VDD), U2.4 (VCC), U2.6 (VCC), U2.18 (AVCC), U2.20 (AREF)

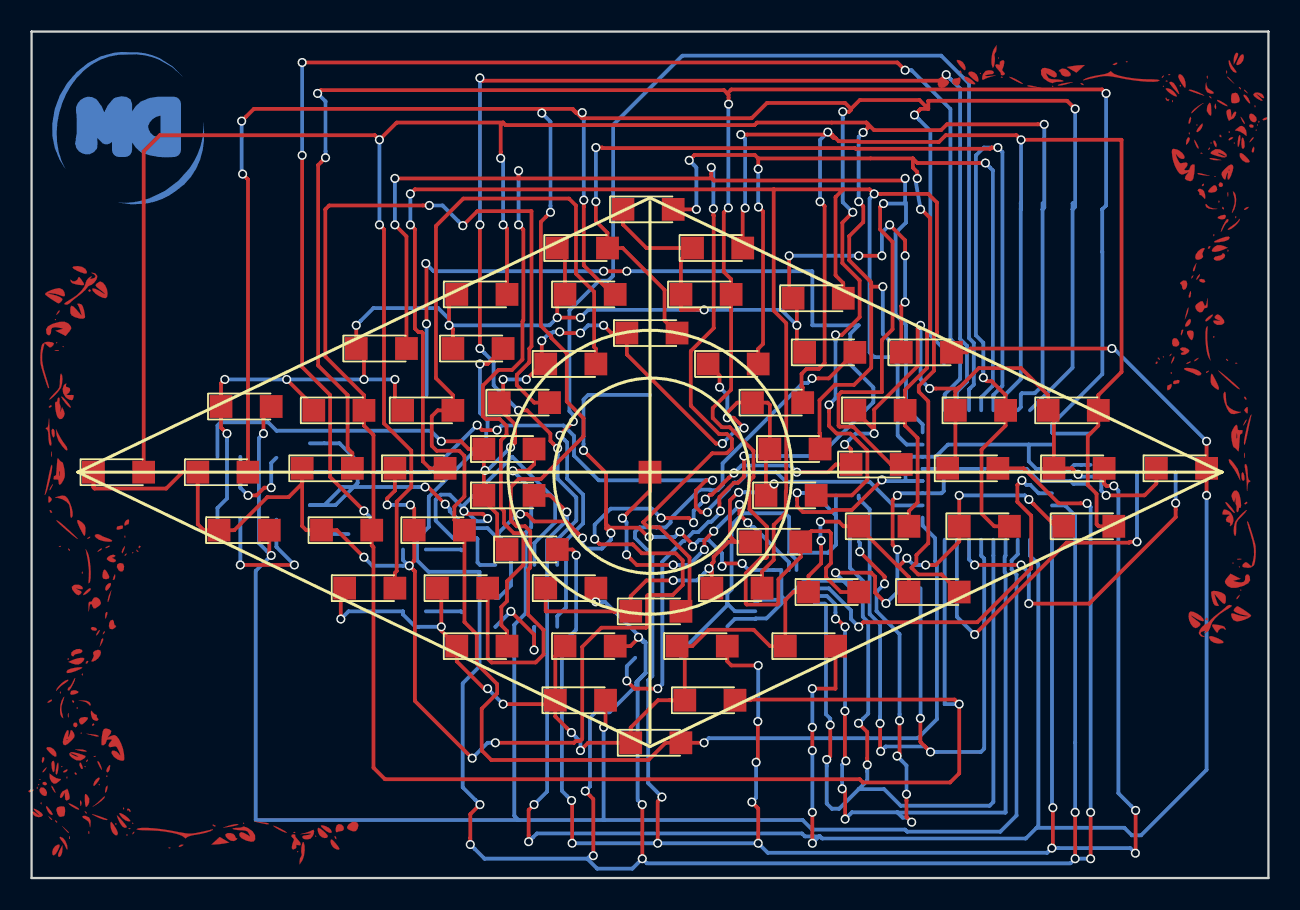
[picture p37: board EvilEye.kicad_pcb from above]

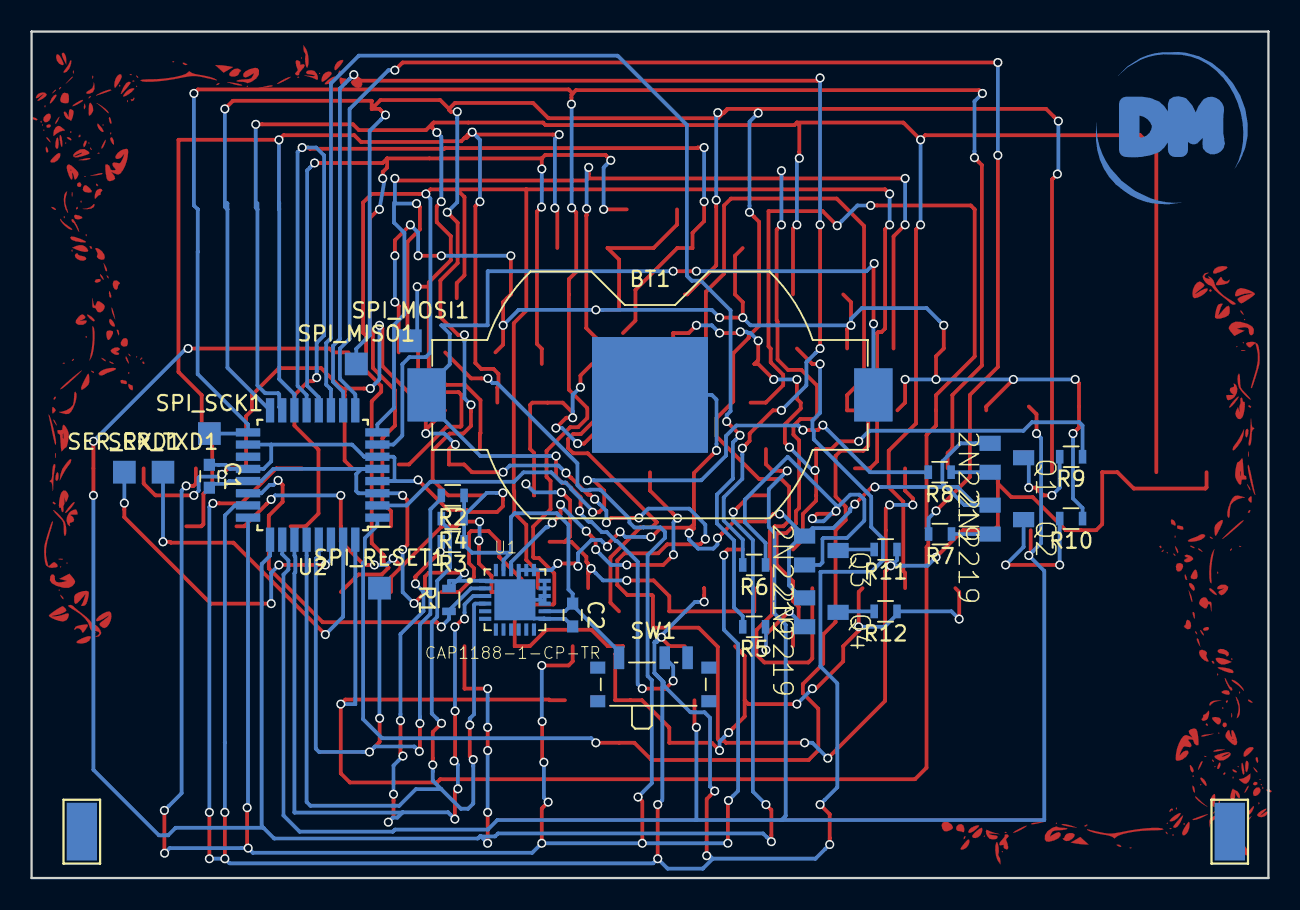
[picture p38: board EvilEye.kicad_pcb from below]

Board: 2 copper layers, 81.3 x 55.6 mm, 86 parts (29 on the bottom side), 40 nets.

Other parts of the board:
svg2mod: G***; logo_dm_10x10mm
