aeronerd/KiCad/(commit log)

2018-01-27 KiCad initial setup and custom libraries working
    [PicoTracker1.kicad_pcb, PicoTracker1.sch]
2018-01-29 KiCad PicoTracker1 mid-development checkin
    [PicoTracker1.kicad_pcb, PicoTracker1.sch]
2018-01-30 KiCad PicoTracker1 pcb done
    [PicoTracker1.kicad_pcb]
2018-02-18 KiCad created breakouts for si4463 and ublox gps
    [BreakoutSI4463.kicad_pcb, BreakoutSI4463.sch, BreakoutUblox.kicad_pcb, BreakoutUblox.sch]
2018-03-22 KiCad Breakout boards for TPS61201 and RFSI4463PRO
    [BreakoutSI4463PRO.kicad_pcb, BreakoutSI4463PRO.sch, BreakoutTPS6120X.kicad_pcb, BreakoutTPS6120X.sch]
2018-03-24 KiCad PicoTracker1Rev2
    [PicoTracker1Rev2.kicad_pcb, PicoTracker1Rev2.sch]
2018-04-15 AVR KiCad added parts relating to WSRP tracker, plus adafruit lib
2018-04-15 AVR KiCad PicoTrackerWSPR1
    [PicoTrackerWSPR1.kicad_pcb, PicoTrackerWSPR1.sch]
2018-05-07 KiCAD PicoTracker1Rev2 gerbers for upload to hackvana
    [PicoTracker1Rev2-B.Cu.gbl, PicoTracker1Rev2-B.Mask.gbs, PicoTracker1Rev2-B.SilkS.gbo, PicoTracker1Rev2-Edge.Cuts.gm1, PicoTracker1Rev2-F.Cu.gtl, PicoTracker1Rev2-F.Mask.gts, PicoTracker1Rev2-F.SilkS.gto, PicoTracker1Rev2.drl]
2018-06-05 KiCad BreakoutTPS6120XWithLayout to investigate regulator issues
    [BreakoutTPS6120XWithLayout.kicad_pcb, BreakoutTPS6120XWithLayout.sch]
2018-09-30 KiCad lib add switch, coincell holder, QFN25
2018-09-30 EvilEye working, DRC pass, no silk yet
    [EvilEye.kicad_pcb, EvilEye.sch]
2018-09-30 KiCad PCB artwork structure initial checkin
2018-09-30 KiCad EvilEye final
    [EvilEye.kicad_pcb]
2018-09-30 KiCad BreakoutCAP1188
    [BreakoutCAP1188.kicad_pcb, BreakoutCAP1188.sch]
2018-10-02 KiCad added face logo
2018-10-02 KiCad DemoBoard1, a heart shape for mom
    [DemoBoard1.kicad_pcb, DemoBoard1.sch, heart-shape.dxf]
2018-10-21 KiCad EvilEye twaeaks and artifacts of upgrading to 5.0
    [EvilEye-2018-10-15-18-19-47.sch, EvilEye-2018-10-15-21-43-13.sch, EvilEye.kicad_pcb, _saved_EvilEye.sch]
2019-02-13 KiCad created template project
    [MyTemplate.kicad_pcb, MyTemplate.sch]
2019-02-13 KiCad added LTC3105 schematic and footprint
2019-02-19 KiCad updated libs to support LTC3105 energy harvester and MSS5131-103 power inductor
2019-02-19 KiCad LTC3105 Energy Harvester Breakout
    [BreakoutLTC3105.kicad_pcb, BreakoutLTC3105.sch]
2019-02-19 KiCad ModuleSolarToStorageLTC3105
    [ModuleSolarToStorageLTC3105.kicad_pcb, ModuleSolarToStorageLTC3105.sch]
2019-02-20 KiCad initial dup of WSPR tracker before modifications
    [PicoTrackerWSPR1Rev2.sch]
2019-02-21 KiCad updated symbols to support AVR with no DRC issues, footprints to have longer pads on SI5351 plus cut trace connector
2019-02-21 KiCad PicoTrackerWSPR1Rev2 schematic good, pcb in progress
    [PicoTrackerWSPR1Rev2.kicad_pcb]
2019-02-23 KiCad PicoTrackerWSPR1Rev2 complete
    [PicoTrackerWSPR1Rev2.kicad_pcb, PicoTrackerWSPR1Rev2.sch]
2019-02-26 KiCad PicoTrackerWSPR1Rev2 added forgotten battery sense voltage divider
    [PicoTrackerWSPR1Rev2.kicad_pcb, PicoTrackerWSPR1Rev2.sch]
2019-03-29 KiCad CustomSchematicLib change GPS pin 8 to be power in so it can attach to pin 9 with no error
2019-03-29 KiCad PicoTrackerWSPR1Rev3 done
    [PicoTrackerWSPR1Rev3.kicad_pcb, PicoTrackerWSPR1Rev3.sch]
2019-03-29 KiCad change regulator footprint to correct stencil pattern
2019-03-29 KiCad PicoTrackerWSPR1Rev3 update to make stencil creation work
    [PicoTrackerWSPR1Rev3.kicad_pcb]
2019-03-29 KiCad PicoTrackerWSPR1Rev3 paste gerber created for stencil
    [PicoTrackerWSPR1Rev3.kicad_pcb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]
2019-03-30 KiCad ModuleSolarToStorageLTC3105 Rev2
    [ModuleSolarToStorageLTC3105.kicad_pcb, ModuleSolarToStorageLTC3105.sch]
2019-03-30 KiCad ModuleSolarToStorageTunableLTC3105 Rev1
    [ModuleSolarToStorageTunableLTC3105.kicad_pcb, ModuleSolarToStorageTunableLTC3105.sch]
2019-04-08 KiCad PicoTrackerWSPR1Rev3 updated cap value on CLKGEN power input from 10uF to .1uF
    [PicoTrackerWSPR1Rev3.sch]
2019-04-23 KiCad AVR schematic updated to be literal TQFP arranged
2019-04-23 KiCad PicoTrackerWSPR1Rev4 forked and updated to use TQFP AVR symbol
    [PicoTrackerWSPR1Rev4.kicad_pcb, PicoTrackerWSPR1Rev4.sch]
2019-05-01 KiCad TCXO symbol and footprints
2019-05-01 KiCad remove temporary file
2019-05-01 KiCad PicoTrackerWSPR1Rev4 done
    [PicoTrackerWSPR1Rev4.kicad_pcb, PicoTrackerWSPR1Rev4.sch]
2019-05-01 KiCad PicoTrackerWSPR1Rev4 gerbers generated
    [PicoTrackerWSPR1Rev4-B_Cu.gbr, PicoTrackerWSPR1Rev4-B_Mask.gbr, PicoTrackerWSPR1Rev4-B_SilkS.gbr, PicoTrackerWSPR1Rev4-Edge_Cuts.gbr, PicoTrackerWSPR1Rev4-F_Cu.gbr, PicoTrackerWSPR1Rev4-F_Mask.gbr, PicoTrackerWSPR1Rev4-F_Paste.gbr, PicoTrackerWSPR1Rev4-F_SilkS.gbr]
2019-05-22 KiCad PicoTrackerWSPR1Rev5
    [PicoTrackerWSPR1Rev5-B_Cu.gbr, PicoTrackerWSPR1Rev5-B_Mask.gbr, PicoTrackerWSPR1Rev5-B_SilkS.gbr, PicoTrackerWSPR1Rev5-Edge_Cuts.gbr, PicoTrackerWSPR1Rev5-F_Cu.gbr, PicoTrackerWSPR1Rev5-F_Mask.gbr, PicoTrackerWSPR1Rev5-F_Paste.gbr, PicoTrackerWSPR1Rev5-F_SilkS.gbr]
2019-05-24 KiCad PicoTracker1Rev2 gerbers
    [PicoTracker1Rev2-B.SilkS.gbo, PicoTracker1Rev2-B_Cu.gbr, PicoTracker1Rev2-B_Mask.gbr, PicoTracker1Rev2-B_SilkS.gbr, PicoTracker1Rev2-Edge_Cuts.gbr, PicoTracker1Rev2-F.SilkS.gto, PicoTracker1Rev2-F_Cu.gbr, PicoTracker1Rev2-F_Mask.gbr]
2020-02-17 added temp sensor MCP9808 schematic and footprint
2020-02-17 added load switch SIP32431DNP3-T1GE4
2020-02-17 added ATMEGA328P-MU footprint
2020-02-18 PicoTrackerWSPR1Rev6 gerbers
    [PicoTrackerWSPR1Rev6-B_Cu.gbr, PicoTrackerWSPR1Rev6-B_Mask.gbr, PicoTrackerWSPR1Rev6-B_Paste.gbr, PicoTrackerWSPR1Rev6-B_SilkS.gbr, PicoTrackerWSPR1Rev6-Edge_Cuts.gbr, PicoTrackerWSPR1Rev6-F_Cu.gbr, PicoTrackerWSPR1Rev6-F_Mask.gbr, PicoTrackerWSPR1Rev6-F_Paste.gbr]
2020-03-16 PicoTrackerWSPR2Rev1 silkscreen
    [PicoTrackerWSPR2Rev1.kicad_pcb]
2020-03-16 PicoTrackerWSPR2Rev1 gerbers
    [PicoTrackerWSPR2Rev1-B_Cu.gbr, PicoTrackerWSPR2Rev1-B_Mask.gbr, PicoTrackerWSPR2Rev1-B_Paste.gbr, PicoTrackerWSPR2Rev1-B_SilkS.gbr, PicoTrackerWSPR2Rev1-Edge_Cuts.gbr, PicoTrackerWSPR2Rev1-F_Cu.gbr, PicoTrackerWSPR2Rev1-F_Mask.gbr, PicoTrackerWSPR2Rev1-F_Paste.gbr]
2020-03-16 BreakoutGPSATGM336H gerbers
    [BreakoutGPSATGM336H-B_Cu.gbr, BreakoutGPSATGM336H-B_Mask.gbr, BreakoutGPSATGM336H-B_Paste.gbr, BreakoutGPSATGM336H-B_SilkS.gbr, BreakoutGPSATGM336H-Edge_Cuts.gbr, BreakoutGPSATGM336H-F_Cu.gbr, BreakoutGPSATGM336H-F_Mask.gbr, BreakoutGPSATGM336H-F_Paste.gbr]
2020-04-08 PicoTrackerWSPR2Rev2 gerbers
    [PicoTrackerWSPR2Rev2-B_Cu.gbr, PicoTrackerWSPR2Rev2-B_Mask.gbr, PicoTrackerWSPR2Rev2-B_Paste.gbr, PicoTrackerWSPR2Rev2-B_SilkS.gbr, PicoTrackerWSPR2Rev2-Edge_Cuts.gbr, PicoTrackerWSPR2Rev2-F_Cu.gbr, PicoTrackerWSPR2Rev2-F_Mask.gbr, PicoTrackerWSPR2Rev2-F_Paste.gbr]
2020-06-27 KiCad add coax footprints
2020-06-27 KiCad SI4463Pro Literal Layout schematic and footprint
2020-06-27 KiCad BreakoutSI4463PRORev2/
    [BreakoutSI4463PRORev2.kicad_pcb, BreakoutSI4463PRORev2.sch]
2020-06-27 BreakoutSI4463PRORev2 gerbers
    [BreakoutSI4463PRORev2-B_Cu.gbr, BreakoutSI4463PRORev2-B_Mask.gbr, BreakoutSI4463PRORev2-B_Paste.gbr, BreakoutSI4463PRORev2-B_SilkS.gbr, BreakoutSI4463PRORev2-Edge_Cuts.gbr, BreakoutSI4463PRORev2-F_Cu.gbr, BreakoutSI4463PRORev2-F_Mask.gbr, BreakoutSI4463PRORev2-F_Paste.gbr]
2020-07-12 SMA EdgeMount BackOnly footprint
2020-07-12 BreakoutSI4463PRORev3 gerbers
    [BreakoutSI4463PRORev3-B_Cu.gbr, BreakoutSI4463PRORev3-B_Mask.gbr, BreakoutSI4463PRORev3-B_Paste.gbr, BreakoutSI4463PRORev3-B_SilkS.gbr, BreakoutSI4463PRORev3-Edge_Cuts.gbr, BreakoutSI4463PRORev3-F_Cu.gbr, BreakoutSI4463PRORev3-F_Mask.gbr, BreakoutSI4463PRORev3-F_Paste.gbr]
2020-08-26 mosfet and regulator schematics/footprints
2020-08-26 BikeLightComputer in-progress
    [BikeLightComputer.kicad_pcb, BikeLightComputer.sch]
2020-08-28 BikeLightComputer done
    [BikeLightComputer.kicad_pcb]
2020-08-28 BikeLightComputer gerbers
    [BikeLightComputer-B_Cu.gbr, BikeLightComputer-B_Mask.gbr, BikeLightComputer-B_Paste.gbr, BikeLightComputer-B_SilkS.gbr, BikeLightComputer-Edge_Cuts.gbr, BikeLightComputer-F_Cu.gbr, BikeLightComputer-F_Mask.gbr, BikeLightComputer-F_Paste.gbr]
2020-08-28 BikeLightComputer Rev2
    [BikeLightComputerRev2-B_Cu.gbr, BikeLightComputerRev2-B_Mask.gbr, BikeLightComputerRev2-B_Paste.gbr, BikeLightComputerRev2-B_SilkS.gbr, BikeLightComputerRev2-Edge_Cuts.gbr, BikeLightComputerRev2-F_Cu.gbr, BikeLightComputerRev2-F_Mask.gbr, BikeLightComputerRev2-F_Paste.gbr]
